studio-1b/Solar-Power-Meter/Mini Digital Current Ammeter Hall Effect.jpg

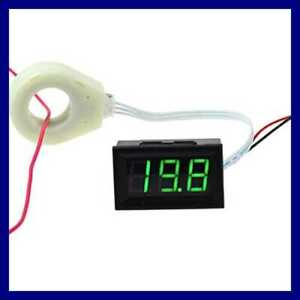
Mini Digital Current Ammeter Hall Effect.jpg
