studio-1b/Solar-Power-Meter/Adafruit 2.13in Monochrome eInk Display 250x122.jpg

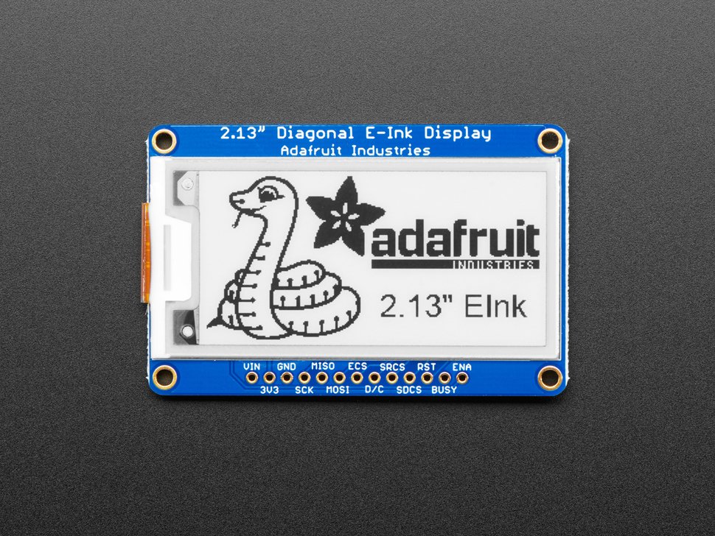
Adafruit 2.13in Monochrome eInk Display 250x122.jpg
