studio-1b/Solar-Power-Meter/README.md

# Solar-Power-Meter
Project to create a power meter for a non-smart solar charger

Blog:https://www.tictawf.com/blog/arduino-centric-solar-power-meter/

Read readme.txt, for a terse UML deployment diagram, for overview of project.  It later has installation instructions.
