studio-1b/Solar-Power-Meter/adafruit 100k potentiometer.jpg

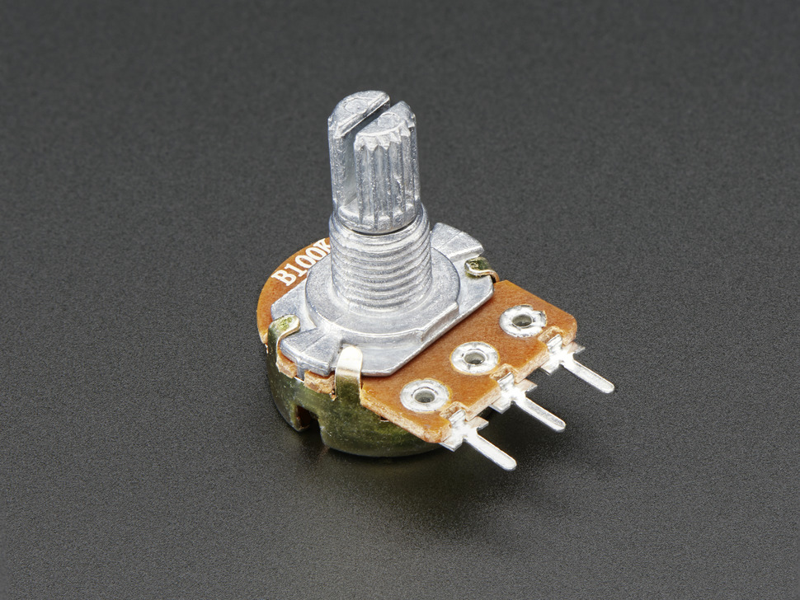
adafruit 100k potentiometer.jpg
