studio-1b/Solar-Power-Meter/arduino diagram.png

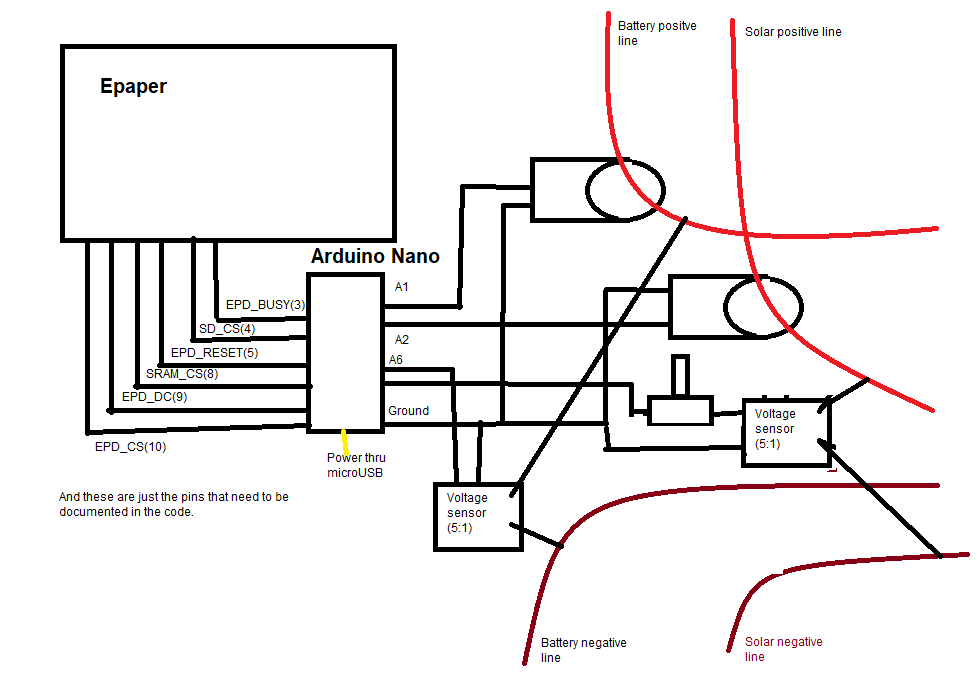
arduino diagram.png
