studio-1b/Solar-Power-Meter/Arduino Nano 33 IoT.jpg

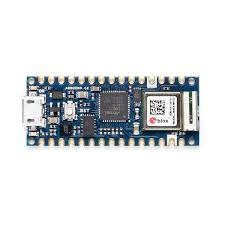
Arduino Nano 33 IoT.jpg
