studio-1b/Solar-Power-Meter/B25 Voltage Sensor Module (5to1 voltage divider).jpg

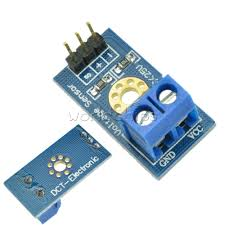
B25 Voltage Sensor Module (5to1 voltage divider).jpg
