studio-1b/Solar-Power-Meter/boardmanager.PNG

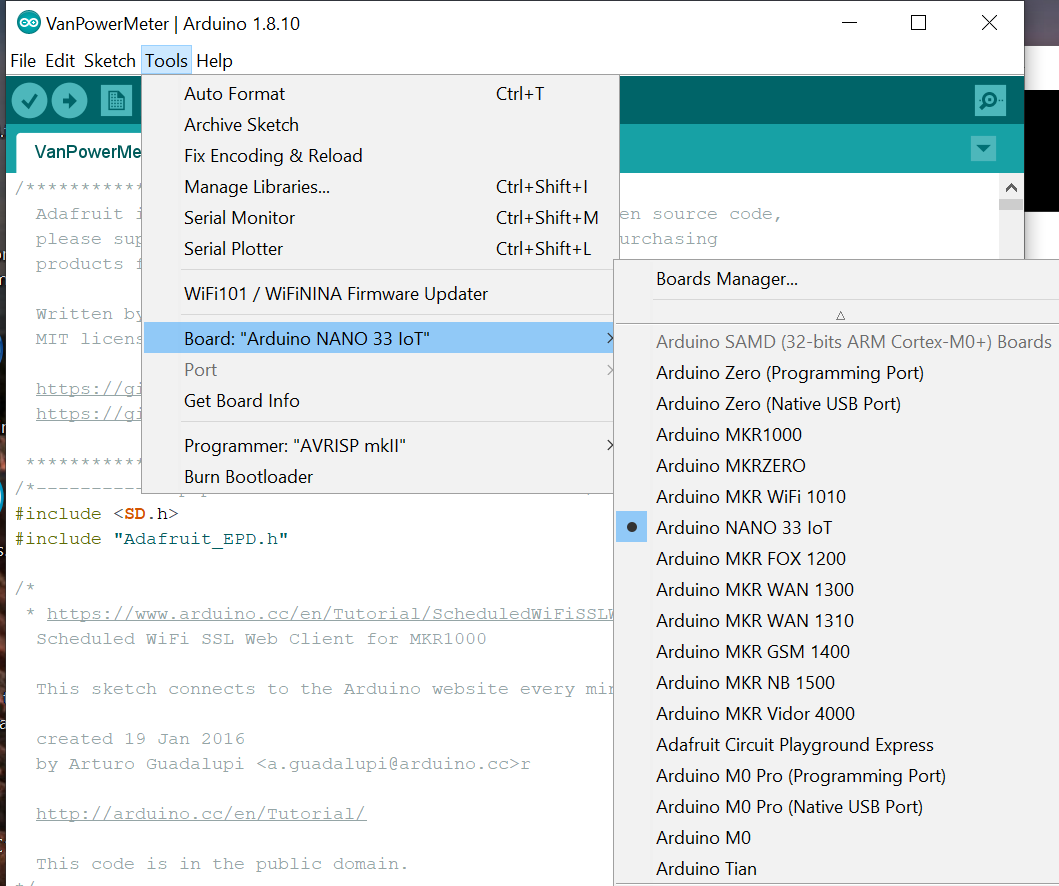
boardmanager.PNG
