studio-1b/Solar-Power-Meter/figurative arduino power sensor.png

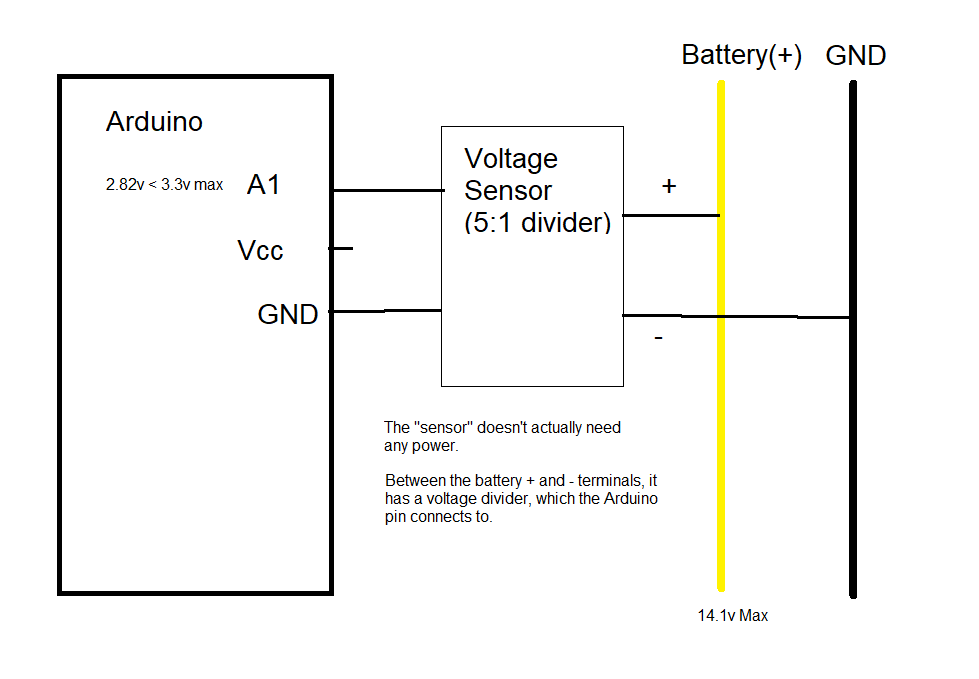
figurative arduino power sensor.png
