studio-1b/Solar-Power-Meter/librarymanager.PNG

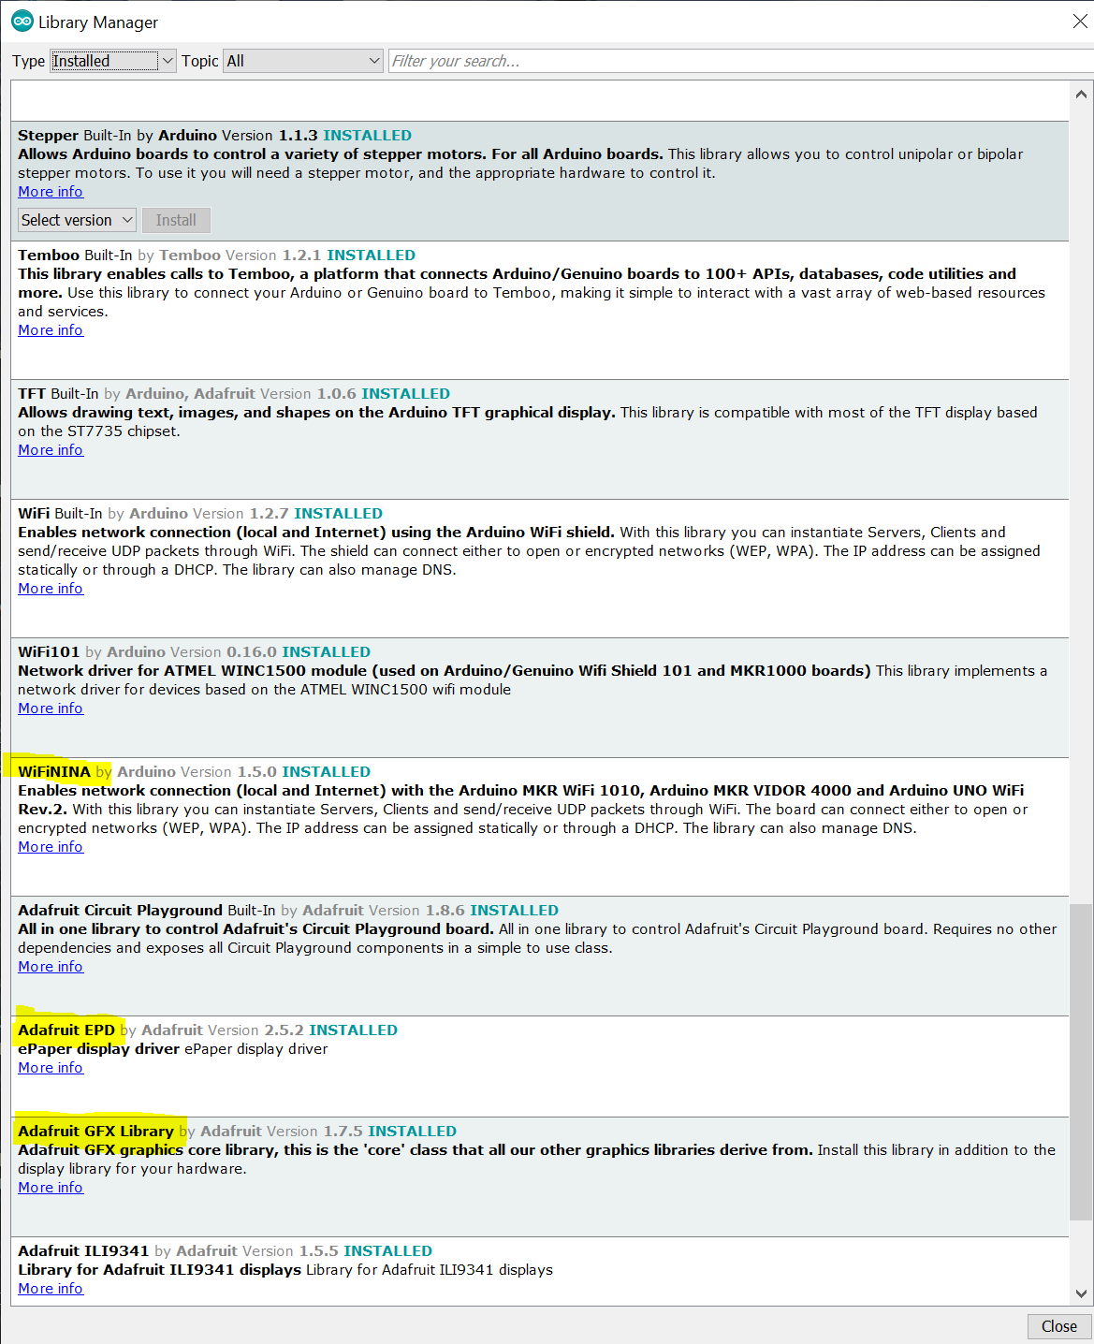
librarymanager.PNG
