studio-1b/Solar-Power-Meter/LinuxCode/HTML/roadtripbusinessend.bmp

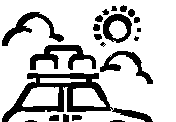
LinuxCode/HTML/roadtripbusinessend.bmp
