studio-1b/Solar-Power-Meter/lubuntu.jpg

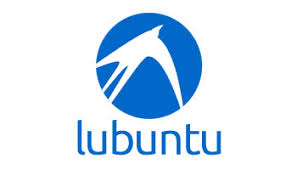
lubuntu.jpg
