studio-1b/Solar-Power-Meter/sample analog sensor.png

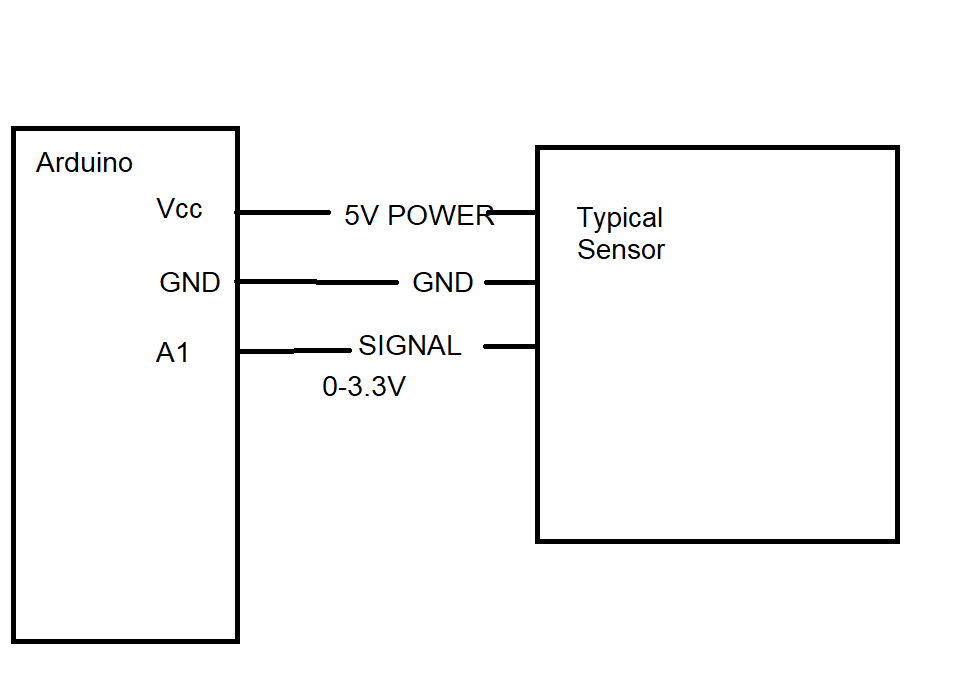
sample analog sensor.png
