studio-1b/Solar-Power-Meter/ArduinoCode/VanPowerMeter.ino

/*
Comments below this comment block, are all credits to people whose code I copied to do this project.


These variables in THIS FILE need to be updated (See right column)

ServerPurpose	Protocol	Type		Variablename
-------------	--------	----		============
heartbeat	http		string		VANPI_WEB_SERVER="ip4 address"
Get time	ntp		IPAddress	gpsServer=IPAddress(0,0,0,0)
						I have private GPSD server,
						but can use public NIST servers
AP association	wifi		IPAddress	THIS_IP=IPAddress(0,0,0,0)
also web server
also sntp

The wifi AP name, and password, need to be updated in arduino_secrets.h

BY: 
1. Yes, all the comments below, are for the .h files
2. Yes, most of the code below is cut-and-paste from example reference code 
   for the specific module supporting the hardware
3. Except the NTP client and server code, which I shamelessly ripped off.
4. And yes, this is my first C program since college.
5. Yes, much of the code is debugging statements, 
   which are controlled by #define DEBUG_??? set to true

For Arduino 33 Nano IOT
Features:
-HTTP Server on port 80 for delivering data, for a datalogger
-NTP client for getting accurate time, for the logger
 -you can configure your own NTP server, if not on internet
-SNTP server, for forwarding time to any other devices
 -drift calculator of emulated clock
-reading analog pins from voltage and current sensors, to be logged
-Epaper UI, to show logged data

The code I copied, I credit with copying their comment headers, before the include libraries they used.
*/



/***************************************************
  Adafruit invests time and resources providing this open source code,
  please support Adafruit and open-source hardware by purchasing
  products from Adafruit!

  Written by Limor Fried/Ladyada for Adafruit Industries.
  MIT license, all text above must be included in any redistribution

  https://github.com/adafruit/Adafruit-GFX-Library
  https://github.com/adafruit/Adafruit_EPD
  
 ****************************************************/
/*----------- epaper includes ---------------------*/
#include <SD.h>
#include "Adafruit_EPD.h"

/*
 * https://www.arduino.cc/en/Tutorial/ScheduledWiFiSSLWebClientfor
  Scheduled WiFi SSL Web Client for MKR1000

  This sketch connects to the Arduino website every minute and downloads the ASCII logo to display it on the serial monitor

  created 19 Jan 2016
  by Arturo Guadalupi <a.guadalupi@arduino.cc>r

  http://arduino.cc/en/Tutorial/

  This code is in the public domain.
*/

#include <SPI.h>
#include <WiFiNINA.h>
#include <RTCZero.h>
#include "arduino_secrets.h" 

/*

 Udp NTP Client

 Get the time from a Network Time Protocol (NTP) time server
 Demonstrates use of UDP sendPacket and ReceivePacket
 For more on NTP time servers and the messages needed to communicate with them,
 see http://en.wikipedia.org/wiki/Network_Time_Protocol

 created 4 Sep 2010
 by Michael Margolis
 modified 9 Apr 2012
 by Tom Igoe

 This code is in the public domain.

 */
#include <WiFiUdp.h>



/* LM: The following is based on NTP_Server_01.ino, downloaded from:
 *     https://forum.arduino.cc/index.php?topic=197870.0
 *     
 *     Original source is named NTP_Server_01.
 *     This sketch includes modifications as summarized below.
 *     
 *                LM:   Platform Arduion Uno + u-blox NEO-M8N
 *     Modifications:   GPS com via _software_ serial (D5 and D6)
 *                      Substitute GPS date/time crack() for library method
 *                      Fix leap year bug for year > 1970
 *                      Invert order of NTP and GPS polling
 *                      Minor trivial changes
 */

/*
  NTP Time Server:
 
 This code is in the public domain.
 */


/*
  Battery Monitor

  This example creates a BLE peripheral with the standard battery service and
  level characteristic. The A0 pin is used to calculate the battery level.

  The circuit:
  - Arduino MKR WiFi 1010, Arduino Uno WiFi Rev2 board, Arduino Nano 33 IoT,
    Arduino Nano 33 BLE, or Arduino Nano 33 BLE Sense board.

  You can use a generic BLE central app, like LightBlue (iOS and Android) or
  nRF Connect (Android), to interact with the services and characteristics
  created in this sketch.

  This example code is in the public domain.
*/

#include <ArduinoBLE.h>


/*
BY: end of includes, and credits
*/





// wifinina lib updated 3/14
#define VERSION               String("0.10.21")
#define SAFE_EPD              false

#define DEBUG_SETUP           false
#define DEBUG_LOOP            false
#define DEBUG_FUNCTIONS       false
#define DEBUG_WIFI            false
#define DEBUG_NTP             false
#define DEBUG_NTPS            false
#define DEBUG_RTC             false
#define DEBUG_HTTP_OUTGOING   false
#define DEBUG_HTTP_INCOMING   false
#define DEBUG_SAMPLING        false
#define DEBUG_BATT_AMP_SAMPL  false
#define DEBUG_BATT_VOLT_SAMPL false
#define DEBUG_SOL_AMP_SAMPL   false
#define DEBUG_SOL_VOLT_SAMPL  false
#define DEBUG_UI              false
#define DEBUG_BMP             false
#define DEBUG_BLE             false
#define DEBUG_FREE_MEMORY     false

#define DEBUG_18V             false
bool isledon = false;

/*----------- epaper defines and global varaiables ---------------------*/
#ifdef ESP8266
   #define SD_CS    2
   #define SRAM_CS 16
   #define EPD_CS   0
   #define EPD_DC   15
#endif
#ifdef ESP32
  #define SD_CS       14
  #define SRAM_CS     32
  #define EPD_CS      15
  #define EPD_DC      33  
#endif
#if defined (__AVR_ATmega32U4__) || defined(ARDUINO_SAMD_FEATHER_M0) || defined(ARDUINO_FEATHER_M4) || defined (__AVR_ATmega328P__) || defined(ARDUINO_NRF52840_FEATHER)
  #define SD_CS       5
  #define SRAM_CS     6
  #define EPD_CS      9
  #define EPD_DC      10  
#endif
#ifdef TEENSYDUINO
  #define SD_CS       8
  #define SRAM_CS     3
  #define EPD_CS      4
  #define EPD_DC      10  
#endif
#ifdef ARDUINO_STM32_FEATHER
   #define TFT_DC   PB4
   #define TFT_CS   PA15
   #define STMPE_CS PC7
   #define SD_CS    PC5
#endif
#ifdef ARDUINO_NRF52832_FEATHER
  #define SD_CS       27
  #define SRAM_CS     30
  #define EPD_CS      31
  #define EPD_DC      11  
#endif
#ifdef ARDUINO_SAMD_NANO_33_IOT  //https://forum.arduino.cc/index.php?topic=636237.0 OR C:\Users\Bob\AppData\Local\Arduino15\packages\arduino\hardware\samd\1.8.4\boards.txt
  #define EPD_DC      9  // https://learn.adafruit.com/adafruit-eink-display-breakouts/arduino-code
  #define EPD_RESET   5  // Normally not defined, and set below
  #define EPD_CS      10 // https://learn.adafruit.com/adafruit-eink-display-breakouts/arduino-code
  #define SRAM_CS     8  // https://learn.adafruit.com/adafruit-eink-display-breakouts/arduino-code
  #define EPD_BUSY    3  // Normally not defined, and set below

  #define SD_CS       4  // Personal Choice to connect to epaper.
#endif

//#define EPD_RESET   -1 // can set to -1 and share with microcontroller Reset!
//#define EPD_BUSY    -1 // can set to -1 to not use a pin (will wait a fixed delay)

/* Uncomment the following line if you are using 2.13" tricolor EPD */
//Adafruit_IL0373 epd(212, 104 ,EPD_DC, EPD_RESET, EPD_CS, SRAM_CS, EPD_BUSY);
/* Uncomment the following line if you are using 2.13" monochrome 250*122 EPD */
Adafruit_SSD1675 epd(250, 122, EPD_DC, EPD_RESET, EPD_CS, SRAM_CS, EPD_BUSY);

//bool drawBitmap = false;
long lastEPDupdatemillis = 0;
bool disableClear = false;



/*----------- Wifi defines and global variables---------------------*/
const String dotToStr = ".";
const String trueToStr = "true";
const String falseToStr = "false";
const String spToStr = " ";

const char null_client_detected_skipping_checking_for_response[] = "null client detected, skipping checking for response";
const char checking_for_http_response[] = "checking for http response";
const char http_response_loop_exit[] = "http response loop exit";
const char received_[] = "received=";
const char __Web[] = "--Web";
const char End_of_HTTP_request_response_parsing_Free_memory_[] = "End of HTTP request/response parsing Free memory=";
const char checking_for_https_response[] = "checking for https response";
const char https_response_loop_exit[] = "https response loop exit";
const char End_of_HTTPS_request_response_parsing_Free_memory_[] = "End of HTTPS request/response parsing, Free memory=";

//char ssid[] = "House";      //  your network SSID (name)
//char pass[] = "@11thAvenue";       // your network password
int keyIndex = 0;                  // your network key Index number (needed only for WEP)

int status = WL_IDLE_STATUS;

// Initialize the Wifi Web client library
//WiFiSSLClient client;
// server address:

//reset
void(*resetFunc)(void) = 0;

// defined web pages to make http requests to
typedef bool (*httpsResponseReceiver)(WiFiSSLClient client);
typedef bool (*httpResponseReceiver)(WiFiClient client);
long uptimeAtAP = 0;

char ARDUINO_WEB_SERVER[] = "www.arduino.cc";
unsigned int ARDUINO_WEB_PORT = 80;
char ARDUINO_LOGO_WEBLOCATION[] = "/asciilogo.txt";

//https://raw.githubusercontent.com/adafruit/Adafruit_Learning_System_Guides/master/EInk_Autostereograms/images/adafruit.bmp
char ADAFRUIT_WEB_SERVER[] = "raw.githubusercontent.com";
unsigned int ADAFRUIT_WEB_PORT = 443;
char ADAFRUIT_LOGO_WEBLOCATION[] = "/adafruit/Adafruit_Learning_System_Guides/master/EInk_Autostereograms/images/adafruit.bmp";

char VANPI_WEB_SERVER[] = GPSD_IP_STR;
unsigned int VANPI_WEB_PORT = 80;
char VANPI_LOGO_WEBLOCATION[] = "/roadtripbusinessend.bmp";

//bool sendRequest = true; // used to understand if the http request must be sent
bool isInternetConnected = false;
bool isNetworkConfigured = false;

/*----------Web Server-----------*/
WiFiServer webserver(80);
//#define REQUESTIN_BUFFER_SIZE 8192
//char httprequestin[REQUESTIN_BUFFER_SIZE]; 


const char HTTP1_1_200_OK[] = "HTTP/1.1 200 OK";
const char Content_Type_text_html[] = "Content-Type: text/html";
const char Connection_close[]="Connection: close";
const char HTML_DOCTYPE_HTML[]="<!DOCTYPE HTML>";
const char HTML_html[]="<html>";
const char HTML_br[]="<br/>";
const char EOL[]="<br />";
const char analog_input[]="analog input ";
const char _is_[]=" is ";
const char  Timestamp_Category_Value_Units_tag_eor[]="Timestamp,Category,Value,Units,tag,<br/>";
const char _SystemVoltage_[]=",SystemVoltage,";
const char milli_[]=",milli-";
const char _BatteryRate_[]=",BatteryRate,";
const char _BatteryNetCharge_[]=",BatteryNetCharge,";
const char _SolarStatus_[]=",SolarStatus,";
const char _SolarSupply_[]=",SolarSupply,";
const char _EstFullCapacity_[]=",EstFullCapacity,";
const char _EstAvailCapacity_[]=",EstAvailCapacity,";
const char _mAh[]=",mAh";
const char EOR[]=",<br />";
const char Timestamp_BatteryAmp_SystemVoltage_SolarStatus_SolarSupply_eor[]="Timestamp,BatteryAmp,SystemVoltage,SolarStatus,SolarSupply,<br />";
const char hourUTC_hourlocal_batterynet_eor[]="hour(UTC),hour(local),batterynet,<br />";
const char TEXT_COMMA[]=",";
const char First_NTP_sync_epoch_[]="First NTP sync epoch = ";
const char Local_time_of_last_outgoing_NTP_sync_request_[]="Local time of last outgoing NTP sync request=";
const char Unix_Epoch_calculated_from_incoming_response_from_NTP_[]="Unix Epoch calculated from incoming response from NTP=";
const char Last_outgoing_NTP_sync_response_sent_to_IP_[] = "Last outgoing NTP sync response sent to IP=";
const char TEXT_PERIOD[]=".";
const char Last_outgoing_NTP_sync_response_sent_epoch_value_[]="Last outgoing NTP sync response sent epoch value=";
const char Number_of_NTP_requests_served_[]="Number of NTP requests served=";
const char Adjustments_to_RTC_actual_elapsed_[]="Adjustments to RTC (actual elapsed)=";
const char _rtc_elapsed___[] = "+(rtc elapsed)*(";
const char TEXT_SLASH[]="/";
const char __eor[]="),<br />";
const char Current_drift_adjustment_to_outgoing_NTP_response[]="Current drift adjustment to outgoing NTP response=";
const char rtc_returned_seconds_elapsed_actual_seconds_elapsed_from_NTP_br[] = "#,rtc returned seconds elapsed, actual seconds elapsed from NTP,<br />";
const char NTP_Sync_Request_received_br[]="NTP Sync Request received<br>";
const char Current_time_is_[] = "Current time is ";
const char NTP_Sync_Request_DENIED_bc_sync_was_just_run_[] = "NTP Sync Request DENIED b/c sync was just run ";
const char seconds_ago_br[] = "seconds ago<br>";
const char br_free_memory_[] = "<br>free memory=";
const char br_raw_[] = "<br>raw=";
const char br_methodcode_[] = "<br>methodcode=";
const char br_line1_[]= "<br>line1=";
const char br_uri_[]= "<br>uri=";
const char br_url_[]= "<br>url=";
const char br_query_[] = "<br>query=";
const char This_url_does_not_exist__No_404_error__But_you_need_to_select_one_of_these_adc_live_powermeter_powerhistory_hourly_ntp[] = "This url does not exist.  No 404 error.  But you need to select one of these: /adc,/live, /powermeter,/powerhistory,/hourly,/ntp";
const char HTML_CHTML[] = "</html>";

const String URL_adc = "/adc";
const String URL_live = "/live";
const String URL_powermeter = "/powermeter";
const String URL_powerhistory = "/powerhistory";
const String URL_hourly = "/hourly";
const String URL_ntp = "/ntp";
const String URL_timesync = "/timesync";



/*----------NTP Client-----------*/
const char Sending_NTP_packet[] = "Sending NTP packet";
const char packet_received[] = "packet received";
const char Seconds_since_Jan_1_1900_[] = "Seconds since Jan 1 1900 = ";
const char Unix_time_[] = "Unix time = ";
const char Epoch_or_date_in_seconds_when_last_synced_with_NTP_[] = "Epoch (or date in seconds) when last synced with NTP = ";
const char Epoch_or_date_in_seconds_of_RTC_[] = "Epoch (or date in seconds) of RTC = ";
const char Seconds_passed_on_RTC_therefore_Expected_from_NTP_[] = "Seconds passed on RTC (therefore Expected from NTP) = ";
const char Epoch_or_date_in_seconds_of_NTP_response_[]  = "Epoch (or date in seconds) of NTP response = ";
const char Seconds_passed_according_to_NTP_therefore_actual_[] = "Seconds passed according to NTP (therefore actual) = ";
const char Data_bin_for_drift_calculation_[] = "Data bin for drift calculation = ";
const char The_UTC_time_is[] = "The_UTC_time_is";
const char __NTP[] = "--NTP";
const char rtc_clock_drift_calculated[] = "rtc clock drift calculated";
const char rtcclock_returned_year_month_day_hr_min_sec_[] = "rtcclock() returned year,month,day,hr,min,sec:";
const char RTC_adjusted_for_drift_to_NTP_server_[] = "RTC adjusted for drift to NTP server: ";
const char sec[] = "sec";
const char End_of_NTPRequest_Free_memory_[] = "End of NTPRequest(), Free memory =";
const char No_NTP_response_received[] = "No NTP response received";

/* Create an rtc object, to handle */
RTCZero rtc;
//const int GMT = 2; //change this to adapt it to your time zone

/*internal storage of timestamps*/
struct utcdatetime {
    unsigned long epoch;
    unsigned int year;
    uint8_t month;
    uint8_t day;
    uint8_t hour;
    uint8_t minute;
    uint8_t second;
};

// NTP sync detail variables
struct utcdatetime datetimeAtConnect;
struct utcdatetime datetimeAtNTP;
unsigned long uptimeAtNTP = 0; 
#define UDP_RESPONSE_PORT 2390        // local port to listen for UDP response
//unsigned int localPort = 2390;      // local port to listen for UDP response
IPAddress timeServer(129, 6, 15, 28); // time.nist.gov NTP server
IPAddress nistServer(129, 6, 15, 28); // time.nist.gov NTP server
IPAddress gpsServer(GPSD_IP_1, GPSD_IP_2, GPSD_IP_3, GPSD_IP_4); // GPSD NTP server
//IPAddress timeServer(128,138,141,172); // utcnist2.colorado.edu NTP server

// A UDP instance to let us send and receive packets over UDP
WiFiUDP Udp2390;
// Global buffer for UDP response packets, and protocol adapter
const int NTP_PACKET_SIZE = 48; // NTP time stamp is in the first 48 bytes of the message
byte packetBuffer[ NTP_PACKET_SIZE]; //buffer to hold incoming and outgoing packets

//Time zone of local
//unsigned long tz = -5; //New York/EST
long tz = -8; //Los Angeles/PST
long tz2 = 0;
String tzabbr = "PST(-8)";

byte rtcdriftindex = 0;
long rtcdriftactual[48];
long rtcdriftexpected[48];
long excludeEpochFromDrift = 0;


/*----------Sensor readings-----------*/
struct linearconv {
    long Bn;
    long Bd;
    long A;
    String units;
};
struct analogsamplesum {
    unsigned long ms;
    unsigned int pin;
    unsigned long count;
    unsigned long sum;
    unsigned int mx;
    unsigned int mn;
    unsigned int avg;
    int calibrate;
    unsigned int tovolts;
    struct linearconv* converter;
    int converted;
};
int fudge_for_ammeter = 1676-1686; //1700, 1676-1710; //-30 //bottom one
int fudge_for_ammeter2 = 1676-1672; //1676-1686 //top one
int fudge_for_voltameter = 2474-2502; //2545; //-69
int sample_count = 300; // 300 is biggest sample for 12bit dac before overflow long numerator of average : 300*4095*3300=4,054,050,000
int sample_delay = 0;
struct linearconv ANALOG_VOLT_TO_AMP = {100,1,-167600, "amps"};  //every millivolt is an amp
//1676*1000 = 1676000
struct linearconv ANALOG_VOLT_TO_12V = {5,1,0, "volts"};  //every millivolt is an amp
//10.81 multimeter on battery
//2.162 multimeter on divider lead
//1.823 on potentiometer lead
//  for 0.84181313 ratio between the 2 voltage divider (1st is 5:1 ratio)
// 1/5 * 1.823/2.162 = 1.823/(5*2.162) = 1.823/10.81 = 1/5.929786 is ratio on second divider
struct linearconv ANALOG_VOLT_TO_18V = {593,100,0, "volts"};  //200Kohm resister on divider made ratio 


// sampling interval control variables
struct aggregate {
    long count;
    long sum;
    int mx;
    int mn;
    int avg;
    struct linearconv* converter;
    int converted;
};
unsigned long nowAhMillis;
long totalAh;
long nowAh;
long nowAhCount;
long nowAhInterval = 60000;
long dischargedAh=0; // should be negative or 0.  Never positive
bool isdischargeestimate = true;
long batteryCapacityAh = 300000;
long lostCapacityAh    = 0;
long sampleStartMillis=0;
unsigned long samplesetMillis;
struct utcdatetime totalAhDatetime;
typedef unsigned long (*MillisGenerator)();
typedef unsigned int (*HourGenerator) ();
MillisGenerator currentMillis;
HourGenerator prevHour;
HourGenerator nowHour;


struct aggregate hourlyAmpSum[24];

struct analogsamplesum amperesMinuteTot = {0, A1, 1, 2048, 0 ,0, 2048, fudge_for_ammeter2, 1676, &ANALOG_VOLT_TO_AMP, 0};
struct analogsamplesum voltageMinuteTot = {0, A6, 0, 0, 0 ,0, 0, fudge_for_voltameter, 0, &ANALOG_VOLT_TO_12V, 0};
struct analogsamplesum solarMinuteTotA = {0, A2, 1, 2048, 0 ,0, 2048, fudge_for_ammeter,1676, &ANALOG_VOLT_TO_AMP, 0};
struct analogsamplesum solarMinuteTotV = {0, A7, 0, 0, 0 ,0, 0, fudge_for_voltameter, 0, &ANALOG_VOLT_TO_18V, 0};

struct analogsamplesum amperesForWeb;
struct analogsamplesum voltageForWeb;
struct analogsamplesum solarAmpForWeb;
struct analogsamplesum solarVoltForWeb;


/* high level drawing routines */
//drawgraph() enumerations
#define NO_BORDER 0
#define SHOW_XY_AXIS 1
#define SHOW_XY_AXIS_W_BORDERS 2
#define DATA_COUNT 144

//data to send to drawgraph() to recreate graph
byte graphdatahead = 0;
//struct utcdatetime datatime[DATA_COUNT]; 
int batteryamppxgraph[DATA_COUNT]; 
int batteryvoltpxgraph[DATA_COUNT]; 
int solaramppxgraph[DATA_COUNT];
int solarvoltpxgraph[DATA_COUNT]; 
//int graphactualmah[DATA_COUNT];

struct downloadable_history {
    //unsigned long epoch;
    struct utcdatetime utc;
    
    int batterymA; //milliamps
    int batterymV; //millivolts
    int solarmA; //milliamps
    int solarmV; //millivolts
}; // it's stored in millivolts and milliamps, but the resolution of the analog readings isn't that good.  Maybe to the tenths place.  The extra numbers are just to support arithmetic and rounding support.
// 12-bit adc means 4096 values, which to have milli-resolution, the thing being measured can only have range 0 to 4.1
struct downloadable_history readings[DATA_COUNT];

// just counters for debugging what is a zero level for amp sensor
long debugginglongtermA = 0;
long debugginglongtermCount = 0;
long debugginglongSolarA = 0;


#define MIN_PER_GRAPH_PX  10 // 144 graph data points.  So 1 means >2hours on graph.  10 means 1440min or 24hours.

typedef void (*DataPoint) (const unsigned int zeroX, const unsigned int zeroY, const int rangePY, const int rangeNY, const int x0, const int y0, const int x1, const int y1);
typedef void (*AxesTick) (const int l, const int t, const int color);

typedef int (*ToPx) (const int y);
struct graphproperties {
    unsigned int zeroX;
    unsigned int zeroY;
    
    int rangePlusY;
    int rangeNegY;
    int rangePlusX;
    int rangeNegX;

    unsigned int lastDataX;
    unsigned int lastDataY;
};

//       overflow for long/ nominal voltage reading = number of readings before overflow
//decide 4000000000/(12000) = 333333.333
//333333.333/60 = 5555.555, assuming 1min per reading, 5555 hours before overflow
//5555.55 / 24 = 231 days before overflow
//so let's log every minute's Ah for an hour, then add that value to a uptime aggregate Ah value.  
//...There is no way that this overflows for a van.  The battery should run out of power.

// 12.75 to 11.50, 
//unsigned byte soc[120] = {};
//trying to set an initial maxAh, from boot

//what to graph, if NTP is unavailable?

// for NTP vs RTC drift calculator
struct linearconv rtcdrift = {0,21600,0,"sec"}; //6 hours = 21600, so the least sqr regression should return in fraction of 21600


/*----------NTP server-----------*/
// All code copied from http://lloydm.net/Demos/NTP/NTP-GPS_Server.ino.txt
//
// buffers for receiving and sending data
const int NTPS_PACKET_SIZE = 48; //same as above sending, and receiving response, but separate instance
byte packetBuffer2[NTPS_PACKET_SIZE];  // same as sending, and receiving response

const char Checking_if_NTP_request_received_on_port_123___[] = "Checking if NTP request received on port 123...";
const char Received_UDP_packet_size_[] = "Received UDP packet size ";
const char From_[] = "From ";
const char __port_[] = ", port ";
const char LI_Vers_Mode_[] = "  LI, Vers, Mode :";
const char Stratum_[] = "  Stratum :";
const char Polling_[] = "  Polling :";
const char Precision_[] = "  Precision :";
const char packet_dump_[] = "packet dump:";
const char Local_time_is_[] = "Local time is =";
const char UTC_Time_in_seconds_[] ="UTC Time in seconds="; 
const char Drift_of_clock_calculated_is_[] = "Drift of clock calculated is="; 
const char UTC_Time_sent_[] = "UTC Time sent="; 
const char Time_sent_is_supposed_to_be_[] = "Time sent is supposed to be =";
const char No_NTP_request_received[] = "No NTP request received";

byte lastremoteip[4];
unsigned long lastremoteepoch;
unsigned long ntpscount;


/*----------Bluetooth-----------*/


BLEService btService("19B10000-E8F2-537E-4F6C-D104768A1214"); // BLE LED Service

// BLE LED Switch Characteristic - custom 128-bit UUID, read and writable by central
BLEUnsignedIntCharacteristic systemVoltageCharacteristic("19B10001-E8F2-537E-4F6C-D104768A1214", BLERead);
BLEUnsignedIntCharacteristic solarVoltageCharacteristic("19B10001-E8F2-537E-4F6C-D104768A1215", BLERead);
BLEIntCharacteristic batterymAmpsCharacteristic("19B10001-E8F2-537E-4F6C-D104768A1216", BLERead);
BLEIntCharacteristic solarmAmpsCharacteristic("19B10001-E8F2-537E-4F6C-D104768A1217", BLERead);
BLELongCharacteristic batteryNetmAhCharacteristic("19B10001-E8F2-537E-4F6C-D104768A1218", BLERead);
BLELongCharacteristic batteryTopDischargemAhCharacteristic("19B10001-E8F2-537E-4F6C-D104768A1219", BLERead);

//BLEUnsignedCharCharacteristic









/*---------------------------------------------------
----------------------------------------------------

Run once at boot

-----------------------------------------------------
----------------------------------------------------*/

void setup() {
  //setDebugMessageLevel(3); // used to set a level of granularity in information output [0...4]
  // initialize digital pin LED_BUILTIN as an output.
  pinMode(LED_BUILTIN, OUTPUT);
  
  /*----------- epaper ---------------------*/
  Serial.begin(115200);

  if(DEBUG_SETUP) {
    for(int i=0; i<2000; i++)
      Serial.print(".");
    Serial.println();
    Serial.println();
    
    Serial.println(F("Van Power Meter Starting"));
    Serial.println(F("setup() enter"));
    
    Serial.print(F("Initializing SD card..."));
  }
  bool drawBitmap =false;
  if (!SD.begin(SD_CS)) {
    if(DEBUG_SETUP) Serial.println(F("failed!"));
  } else {
    drawBitmap = true;
    File root = SD.open("/");
    printDirectory(root, 0);
    if(DEBUG_SETUP) Serial.println(F("done!"));
  }

  if(DEBUG_SETUP) {
    Serial.println(F("Big object sizes..."));


    long bigobjects = 0;
//    Serial.println(F("Graph Data x-axis dates:"));
//    Serial.print(sizeof(datatime));
//    bigobjects += sizeof(datatime);
//    Serial.print(F(" / "));
//    Serial.println(bigobjects);
    
    Serial.println(F("Graph Data y-axis voltage values:"));
    Serial.print(sizeof(batteryvoltpxgraph));
    bigobjects += sizeof(batteryvoltpxgraph);
    Serial.print(F(" / "));
    Serial.println(bigobjects);

    Serial.println(F("Graph Data y-axis amp values:"));
    Serial.print(sizeof(solaramppxgraph));
    bigobjects += sizeof(solaramppxgraph);
    Serial.print(F(" / "));
    Serial.println(bigobjects);

    Serial.println(F("Graph Data y-axis solar voltage values:"));
    Serial.print(sizeof(solarvoltpxgraph));
    bigobjects += sizeof(solarvoltpxgraph);
    Serial.print(F(" / "));
    Serial.println(bigobjects);

    //Serial.println(F("Graph Data integration of y-values :"));
    //Serial.print(sizeof(graphactualmah));
    //bigobjects += sizeof(graphactualmah);
    //Serial.print(F(" / "));
    //Serial.println(bigobjects);


    Serial.println(F("Daily amp (dis)charge avg by hour :"));
    Serial.print(sizeof(hourlyAmpSum));
    bigobjects += sizeof(hourlyAmpSum);
    Serial.print(F(" / "));
    Serial.println(bigobjects);

    
//    Serial.println("History Timestamps :");
//    Serial.print(sizeof(historytimestamp));
//    bigobjects += sizeof(utcdatetime) * HISTORY_LENGTH;
//    Serial.print(" / ");
//    Serial.println(bigobjects);

    Serial.println(F("History Readings :"));
//    Serial.print(sizeof(historyamp) + sizeof(historyvolt) + sizeof(historysolarvolt) + sizeof(historysolaramp) );
//    bigobjects += sizeof(historyamp) + sizeof(historyvolt) + sizeof(historysolarvolt) + sizeof(historysolaramp);
    Serial.print(sizeof(readings));
    bigobjects += sizeof(readings);
    Serial.print(F(" / "));
    Serial.println(bigobjects);
    
    Serial.println(F("Total array initialization:"));
    Serial.print(bigobjects);
    Serial.println(F("/32,000 SRAM for Arduino Nano 33 IoT"));
    //https://www.mouser.com/new/arduino/arduino-nano-33-iot/

    
    Serial.println(F("Strings in constant area :"));

    Serial.print(dotToStr);
    Serial.print(sizeof(dotToStr) + dotToStr.length());
    bigobjects += sizeof(dotToStr + dotToStr.length());
    Serial.print(F(" / "));
    Serial.println(bigobjects);
    
    Serial.print(trueToStr);
    Serial.print(sizeof(trueToStr) + trueToStr.length());
    bigobjects += sizeof(trueToStr + trueToStr.length());
    Serial.print(F(" / "));
    Serial.println(bigobjects);
    
    Serial.print(falseToStr);
    Serial.print(sizeof(falseToStr) + falseToStr.length());
    bigobjects += sizeof(falseToStr + falseToStr.length());
    Serial.print(F(" / "));
    Serial.println(bigobjects);
    
    Serial.print(spToStr);
    Serial.print(sizeof(spToStr) + spToStr.length());
    bigobjects += sizeof(spToStr + spToStr.length());
    Serial.print(F(" / "));
    Serial.println(bigobjects);

    
    Serial.print(Checking_if_NTP_request_received_on_port_123___);
    Serial.print(sizeof(Checking_if_NTP_request_received_on_port_123___));
    bigobjects += sizeof(Checking_if_NTP_request_received_on_port_123___);
    Serial.print(F(" / "));
    Serial.println(bigobjects);

    Serial.print(Received_UDP_packet_size_);
    Serial.print(sizeof(Received_UDP_packet_size_) );
    bigobjects += sizeof(Received_UDP_packet_size_);
    Serial.print(F(" / "));
    Serial.println(bigobjects);

    Serial.print(From_);
    Serial.print(sizeof(From_));
    bigobjects += sizeof(From_);
    Serial.print(F(" / "));
    Serial.println(bigobjects);

    Serial.print(__port_);
    Serial.print(sizeof(__port_));
    bigobjects += sizeof(__port_);
    Serial.print(F(" / "));
    Serial.println(bigobjects);

    Serial.print(LI_Vers_Mode_);
    Serial.print(sizeof(LI_Vers_Mode_));
    bigobjects += sizeof(LI_Vers_Mode_);
    Serial.print(F(" / "));
    Serial.println(bigobjects);

    Serial.print(Stratum_);
    Serial.print(sizeof(Stratum_));
    bigobjects += sizeof(Stratum_);
    Serial.print(F(" / "));
    Serial.println(bigobjects);
    
    Serial.print(Polling_);
    Serial.print(sizeof(Polling_));
    bigobjects += sizeof(Polling_);
    Serial.print(F(" / "));
    Serial.println(bigobjects);
    
    Serial.print(Precision_);
    Serial.print(sizeof(Precision_));
    bigobjects += sizeof(Precision_);
    Serial.print(F(" / "));
    Serial.println(bigobjects);

    Serial.print(packet_dump_);
    Serial.print(sizeof(packet_dump_));
    bigobjects += sizeof(packet_dump_);
    Serial.print(F(" / "));
    Serial.println(bigobjects);

    Serial.print(Local_time_is_);
    Serial.print(sizeof(Local_time_is_));
    bigobjects += sizeof(Local_time_is_);
    Serial.print(F(" / "));
    Serial.println(bigobjects);

    Serial.print(UTC_Time_in_seconds_);
    Serial.print(sizeof(UTC_Time_in_seconds_));
    bigobjects += sizeof(UTC_Time_in_seconds_);
    Serial.print(F(" / "));
    Serial.println(bigobjects);

    Serial.print(Drift_of_clock_calculated_is_);
    Serial.print(sizeof(Drift_of_clock_calculated_is_));
    bigobjects += sizeof(Drift_of_clock_calculated_is_);
    Serial.print(F(" / "));
    Serial.println(bigobjects);

    Serial.print(UTC_Time_sent_);
    Serial.print(sizeof(UTC_Time_sent_));
    bigobjects += sizeof(UTC_Time_sent_);
    Serial.print(F(" / "));
    Serial.println(bigobjects);

    Serial.print(Time_sent_is_supposed_to_be_);
    Serial.print(sizeof(Time_sent_is_supposed_to_be_));
    bigobjects += sizeof(Time_sent_is_supposed_to_be_);
    Serial.print(F(" / "));
    Serial.println(bigobjects);

    Serial.print(No_NTP_request_received);
    Serial.print(sizeof(No_NTP_request_received));
    bigobjects += sizeof(No_NTP_request_received);
    Serial.print(F(" / "));
    Serial.println(bigobjects);

    Serial.print(null_client_detected_skipping_checking_for_response);
    Serial.print(sizeof(null_client_detected_skipping_checking_for_response));
    bigobjects += sizeof(null_client_detected_skipping_checking_for_response);
    Serial.print(F(" / "));
    Serial.println(bigobjects);

    Serial.print(checking_for_http_response);
    Serial.print(sizeof(checking_for_http_response));
    bigobjects += sizeof(checking_for_http_response);
    Serial.print(F(" / "));
    Serial.println(bigobjects);

    Serial.print(http_response_loop_exit);
    Serial.print(sizeof(http_response_loop_exit));
    bigobjects += sizeof(http_response_loop_exit);
    Serial.print(F(" / "));
    Serial.println(bigobjects);

    Serial.print(received_);
    Serial.print(sizeof(received_));
    bigobjects += sizeof(received_);
    Serial.print(F(" / "));
    Serial.println(bigobjects);

    Serial.print(__Web);
    Serial.print(sizeof(__Web));
    bigobjects += sizeof(__Web);
    Serial.print(F(" / "));
    Serial.println(bigobjects);

    Serial.print(End_of_HTTP_request_response_parsing_Free_memory_);
    Serial.print(sizeof(End_of_HTTP_request_response_parsing_Free_memory_));
    bigobjects += sizeof(End_of_HTTP_request_response_parsing_Free_memory_);
    Serial.print(F(" / "));
    Serial.println(bigobjects);

    Serial.print(checking_for_https_response);
    Serial.print(sizeof(checking_for_https_response));
    bigobjects += sizeof(checking_for_https_response);
    Serial.print(F(" / "));
    Serial.println(bigobjects);

    Serial.print(https_response_loop_exit);
    Serial.print(sizeof(https_response_loop_exit));
    bigobjects += sizeof(https_response_loop_exit);
    Serial.print(F(" / "));
    Serial.println(bigobjects);

    Serial.print(End_of_HTTPS_request_response_parsing_Free_memory_);
    Serial.print(sizeof(End_of_HTTPS_request_response_parsing_Free_memory_));
    bigobjects += sizeof(End_of_HTTPS_request_response_parsing_Free_memory_);
    Serial.print(F(" / "));
    Serial.println(bigobjects);


    Serial.print(Sending_NTP_packet);
    Serial.print(sizeof(Sending_NTP_packet));
    bigobjects += sizeof(Sending_NTP_packet);
    Serial.print(F(" / "));
    Serial.println(bigobjects);

    Serial.print(packet_received);
    Serial.print(sizeof(packet_received));
    bigobjects += sizeof(packet_received);
    Serial.print(F(" / "));
    Serial.println(bigobjects);

    Serial.print(Seconds_since_Jan_1_1900_);
    Serial.print(sizeof(Seconds_since_Jan_1_1900_));
    bigobjects += sizeof(Seconds_since_Jan_1_1900_);
    Serial.print(F(" / "));
    Serial.println(bigobjects);

    Serial.print(Unix_time_);
    Serial.print(sizeof(Unix_time_));
    bigobjects += sizeof(Unix_time_);
    Serial.print(F(" / "));
    Serial.println(bigobjects);

    Serial.print(Epoch_or_date_in_seconds_when_last_synced_with_NTP_);
    Serial.print(sizeof(Epoch_or_date_in_seconds_when_last_synced_with_NTP_));
    bigobjects += sizeof(Epoch_or_date_in_seconds_when_last_synced_with_NTP_);
    Serial.print(F(" / "));
    Serial.println(bigobjects);

    Serial.print(Epoch_or_date_in_seconds_of_RTC_);
    Serial.print(sizeof(Epoch_or_date_in_seconds_of_RTC_));
    bigobjects += sizeof(Epoch_or_date_in_seconds_of_RTC_);
    Serial.print(F(" / "));
    Serial.println(bigobjects);

    Serial.print(Seconds_passed_on_RTC_therefore_Expected_from_NTP_);
    Serial.print(sizeof(Seconds_passed_on_RTC_therefore_Expected_from_NTP_));
    bigobjects += sizeof(Seconds_passed_on_RTC_therefore_Expected_from_NTP_);
    Serial.print(F(" / "));
    Serial.println(bigobjects);

    Serial.print(Epoch_or_date_in_seconds_of_NTP_response_);
    Serial.print(sizeof(Epoch_or_date_in_seconds_of_NTP_response_));
    bigobjects += sizeof(Epoch_or_date_in_seconds_of_NTP_response_);
    Serial.print(F(" / "));
    Serial.println(bigobjects);
    
    Serial.print(Seconds_passed_according_to_NTP_therefore_actual_);
    Serial.print(sizeof(Seconds_passed_according_to_NTP_therefore_actual_));
    bigobjects += sizeof(Seconds_passed_according_to_NTP_therefore_actual_);
    Serial.print(F(" / "));
    Serial.println(bigobjects);

    Serial.print(Data_bin_for_drift_calculation_);
    Serial.print(sizeof(Data_bin_for_drift_calculation_));
    bigobjects += sizeof(Data_bin_for_drift_calculation_);
    Serial.print(F(" / "));
    Serial.println(bigobjects);

    Serial.print(The_UTC_time_is);
    Serial.print(sizeof(The_UTC_time_is));
    bigobjects += sizeof(The_UTC_time_is);
    Serial.print(F(" / "));
    Serial.println(bigobjects);

    Serial.print(__NTP);
    Serial.print(sizeof(__NTP));
    bigobjects += sizeof(__NTP);
    Serial.print(F(" / "));
    Serial.println(bigobjects);

    Serial.print(rtc_clock_drift_calculated);
    Serial.print(sizeof(rtc_clock_drift_calculated));
    bigobjects += sizeof(rtc_clock_drift_calculated);
    Serial.print(F(" / "));
    Serial.println(bigobjects);

    Serial.print(rtcclock_returned_year_month_day_hr_min_sec_);
    Serial.print(sizeof(rtcclock_returned_year_month_day_hr_min_sec_));
    bigobjects += sizeof(rtcclock_returned_year_month_day_hr_min_sec_);
    Serial.print(F(" / "));
    Serial.println(bigobjects);

    Serial.print(RTC_adjusted_for_drift_to_NTP_server_);
    Serial.print(sizeof(RTC_adjusted_for_drift_to_NTP_server_));
    bigobjects += sizeof(RTC_adjusted_for_drift_to_NTP_server_);
    Serial.print(F(" / "));
    Serial.println(bigobjects);

    Serial.print(sec);
    Serial.print(sizeof(sec));
    bigobjects += sizeof(sec);
    Serial.print(F(" / "));
    Serial.println(bigobjects);

    Serial.print(End_of_NTPRequest_Free_memory_);
    Serial.print(sizeof(End_of_NTPRequest_Free_memory_));
    bigobjects += sizeof(End_of_NTPRequest_Free_memory_);
    Serial.print(F(" / "));
    Serial.println(bigobjects);

    Serial.print(No_NTP_response_received);
    Serial.print(sizeof(No_NTP_response_received));
    bigobjects += sizeof(No_NTP_response_received);
    Serial.print(F(" / "));
    Serial.println(bigobjects);

    
    Serial.print(URL_adc);
    Serial.print(sizeof(URL_adc));
    bigobjects += sizeof(URL_adc);
    Serial.print(F(" / "));
    Serial.println(bigobjects);
    
    Serial.print(URL_live);
    Serial.print(sizeof(URL_live));
    bigobjects += sizeof(URL_live);
    Serial.print(F(" / "));
    Serial.println(bigobjects);
    
    Serial.print(URL_powermeter);
    Serial.print(sizeof(URL_powermeter));
    bigobjects += sizeof(URL_powermeter);
    Serial.print(F(" / "));
    Serial.println(bigobjects);
    
    Serial.print(URL_powerhistory);
    Serial.print(sizeof(URL_powerhistory));
    bigobjects += sizeof(URL_powerhistory);
    Serial.print(F(" / "));
    Serial.println(bigobjects);
    
    Serial.print(URL_hourly);
    Serial.print(sizeof(URL_hourly));
    bigobjects += sizeof(URL_hourly);
    Serial.print(F(" / "));
    Serial.println(bigobjects);
    
    Serial.print(URL_ntp);
    Serial.print(sizeof(URL_ntp));
    bigobjects += sizeof(URL_ntp);
    Serial.print(F(" / "));
    Serial.println(bigobjects);
    
    Serial.print(URL_timesync);
    Serial.print(sizeof(URL_timesync));
    bigobjects += sizeof(URL_timesync);
    Serial.print(F(" / "));
    Serial.println(bigobjects);


    Serial.println(F("Partial string initialization + array:"));
    Serial.print(bigobjects);
    Serial.println(F("/32,000 SRAM for Arduino Nano 33 IoT"));
    //https://www.mouser.com/new/arduino/arduino-nano-33-iot/

  }
  

  if(DEBUG_SETUP) Serial.println(F("EPD begin"));
  epd.begin();
  epd.setTextWrap(true);
  epd.setTextSize(1);

  if(DEBUG_SETUP) Serial.println(F("Starting e-paper startup self-diagnostic... it just draws random stuff so you know it's working"));
  // Draw a bitmap
  if (drawBitmap) {
    epd.clearBuffer();  
    epd.fillScreen(EPD_WHITE);
    bmpDraw("/blinka.bmp",0,0);
  
    delay(15*1000);
  }
  startupdraw();

  //initialize critical method calls, to see if the stack space is sufficient.
  //initializing here, puts any variables that seem persistent on the heap, at the bottom of the heap
  //so that fragmentation can be fixed.
  if(DEBUG_FREE_MEMORY) {
    Serial.print(F("Before intializing critical methods, Free memory="));
    Serial.println(freeMemory());    
  }
  //for listenTo...(), the isNetworkConfigured is currently false, so it will abort checking for HTTP response, regardless of input parameters
  listenToClient(NULL);
  listenToSslClient(NULL);
  if(DEBUG_FREE_MEMORY) {
    Serial.print(F("After intializing critical methods, Free memory="));
    Serial.println(freeMemory());    
  }


  /*----------- Wifi ---------------------*/
  connectToAP();    // connect the board to the access point

  // always start whether or not connection is made, waiting for it to connect later.  
  // restarting these services at reconnect might cause malfunction.  
  // Unfortunately, no way to tell if after wifi connection and disconnection, to check these services are still ok
  if(DEBUG_SETUP) Serial.println(F("starting HTTP server"));
  webserver.begin(); 
  if(DEBUG_SETUP) Serial.println(F("starting response listener for NTP request"));
  Udp2390.begin(UDP_RESPONSE_PORT); // unfortunately to be lazy at code, we listen even when we don't send a request.  Just ignore, and flush it before we send a NTP request
  if(DEBUG_SETUP) Serial.println(F("starting NTPS"));
  startServerNTP();
      
  if(isWifiConnected()) {
    if(DEBUG_SETUP) Serial.println(F("setup() Wifi connected"));
    printWifiStatus();

    /*-- Webserver... It's going to be at least 45seconds before next service --*/
    if(DEBUG_SETUP) Serial.println(F("initial HTTP request check"));
    httprequesthandle();
  
    /*------------NTP UDP--------------------------*/
    if(DEBUG_SETUP) Serial.println(F("sending NTP request for current time"));
    
    // unsigned long epoch = WiFi.getTime(); //used the old examples for NTP b/c I can't figure out where to change the NTP server in this call
    // rtc.setEpoch(epoch); //so this line is in ntprequest(), after custom coded call to NTP
    rtc.begin();
    ntprequest(); // this will assume NIST server, so van boot will take a little longer NIST doesnt respond.
    delay(15000); //force a delay here...

    if(DEBUG_FREE_MEMORY) {
      Serial.print(F("After starting NTPS, Free memory="));
      Serial.println(freeMemory());    
    }
      
    // Check connectivity to Internet thru website
    if(DEBUG_SETUP) Serial.println(F("making http request"));
    configureNetwork();
    //httpRequest(ARDUINO_WEB_SERVER, ARDUINO_LOGO_WEBLOCATION, ARDUINO_WEB_PORT);
    //disableClear = true;
    //httpsRequest(ADAFRUIT_WEB_SERVER, ADAFRUIT_LOGO_WEBLOCATION, ADAFRUIT_WEB_PORT);
    //disableClear = false;
  }

  /*------------ Sensor Data collection setup --------------------------*/
  analogReadResolution(12);

  for(int i=0; i<DATA_COUNT; i++) {
    readings[i].utc.epoch=0;
  }

  //1676*4095/3300 = 2079.7636
  struct aggregate zeroreadingAh = {0 ,0, 0, 0, 0, NULL, 0};
  for(int i=0; i<24; i++)
    hourlyAmpSum[i] = zeroreadingAh;
  
  // there are two counters.  one that resets at top of second hand, another resets at top of hour hand.
  if(validclock()) { // we want samplesets to reset on the minute hand of clock
    currentMillis = rtcMinuteMillis;
    prevHour = rtcPrevHour;
    nowHour = rtcNowHour;

    samplesetMillis = millis();
    struct utcdatetime now = rtcclock();

    samplesetMillis -= now.second*1000;
    nowAhMillis = samplesetMillis; // - now.minute*60000UL;
    totalAhDatetime = now;
    nowAhInterval = samplesetMillis + (60-now.minute)*60000UL;
    
  } else {
    currentMillis = uptimeMinuteMillis;
    prevHour = uptimePrevHour;
    nowHour = uptimeNowHour;

    samplesetMillis = millis(); //we have no clock, so we can't tell which minute is is, anymore.
    nowAhMillis = samplesetMillis;
  }
  

  if(DEBUG_SETUP) Serial.println(F("Initial sensor readings"));
  struct analogsamplesum amperes = amperesForWeb = getsample(A1, fudge_for_ammeter2, &ANALOG_VOLT_TO_AMP);
  struct analogsamplesum voltage = voltageForWeb = getsample(A6, fudge_for_voltameter, &ANALOG_VOLT_TO_12V);
  struct analogsamplesum solarA = solarAmpForWeb = getsample(A2, fudge_for_ammeter, &ANALOG_VOLT_TO_AMP);
  struct analogsamplesum solarV = solarVoltForWeb = getsample(A7, fudge_for_voltameter, &ANALOG_VOLT_TO_18V);
  // absAmpReading(&solarA);
  solarAmpForWeb = solarA;

//struct analogsamplesum amperesForWeb;
//struct analogsamplesum voltageForWeb;
//struct analogsamplesum solarAmpForWeb;
//struct analogsamplesum solarVoltForWeb;

  if(DEBUG_SETUP) {
    struct analogsamplesum tmp = getsample(A2, fudge_for_ammeter, &ANALOG_VOLT_TO_AMP);
    for(int i=0; i<4096; i++) {
      tmp.sum = tmp.count * i;
      computesampleAvg(&tmp);
      computesampleVolts(&tmp);
      computesampleConversion(&tmp);
      Serial.print(F("Test reading="));
      Serial.print(tmp.avg);
      Serial.print(F(" mv="));
      Serial.print(tmp.tovolts);
      Serial.print(F(" amps="));
      Serial.print(tmp.converted);
      absAmpReading(&tmp);
      Serial.print(F("       ABS'ed="));
      Serial.print(tmp.avg);
      Serial.print(F(" mv="));
      Serial.print(tmp.tovolts);
      Serial.print(F(" amp="));
      Serial.println(tmp.converted);
    }
  }
  
  // estimate battery state of change and current capacity supported
  // first establish depth of discharge. maxAh = -50ah
  // then use amp hours from then on, another -50ah = -100ah, or 33%
  // then use amp house from then on, another + 70ah = -30ah, etc
  // but when amps <1 and voltage > 13, this means it's fullly charged
  // if ah =-30, interpret real capacity has decreased and this is new capacity    
  if(DEBUG_SETUP) {
    Serial.println(F("Initializing depth of discharge"));
    Serial.println(F("discharge table"));
    Serial.print("     ");
    for(int amp=0; amp<20000; amp+=2000) {
      Serial.print(amp);
      Serial.print(F("mA|"));
    }
    Serial.println();
    for(int volt=12700; volt>11500; volt-=200) {
      Serial.print(volt);
      Serial.print(F("mv|"));
      for(int discharge=0; discharge<20000; discharge+=2000){
        int soc = estimateStateOfCharge(volt, -discharge);
        Serial.print(soc);
        Serial.print(F("|"));
      }
      Serial.println();
    }
    Serial.println(F("charging table"));
    for(int volt=11300; volt<13000; volt+=200) {
      Serial.print(volt);
      Serial.print(F("v|"));
      for(int charge=0; charge<20000; charge+=2000){
        int soc = estimateStateOfCharge(volt, charge);
        Serial.print(soc);
        Serial.print(F("|"));
      }
      Serial.println();
    }
  }
  updatestateofcharge(0, amperes.converted, voltage.converted);
  if(DEBUG_SETUP) {   
    Serial.print(F("Voltage read = "));
    Serial.println(voltage.converted);
    Serial.print(F("Initial Estimated Battery State of charge = "));
    Serial.println(dischargedAh);
    Serial.print(F("/"));
    Serial.println(batteryCapacityAh);
  }


  addToGraph(amperes, voltage, solarA, solarV);

  if(DEBUG_SETUP) {   
    Serial.println(F("setup() exit"));
  }
}





//the cooperative multitasker... if one of the tasks stall, oh well...
void loop() {
  if(DEBUG_LOOP)
      Serial.println(F("Next loop"));
  if(DEBUG_FREE_MEMORY) {
      Serial.print(F("Free memory="));
      Serial.println(freeMemory());    
  }

  if(isledon)
    digitalWrite(LED_BUILTIN, HIGH);   // turn the LED on (HIGH is the voltage level)
  else
    digitalWrite(LED_BUILTIN, LOW);    // turn the LED off by making the voltage LOW
  isledon=!isledon;
  
  // double check that WIFI is still connected WL_CONNECTED || WL_IDLE_STATUS
  //  show update, when it fails
  if(!isWifiConnected()) {
    if(DEBUG_LOOP)
      Serial.println(F("Wifi lost... attempting to reconnect..."));
    connectToAP();
    // show wifi connection
    if(isWifiConnected()) {
      printWifiStatus();
      // has e-paper display() call, and everyone should have 15 second delay built in

      /*------------NTP UDP, to time servers, receiving response on UDP_RESPONSE_PORT --------------------------*/
      rtc.begin(); 
      Udp2390.begin(UDP_RESPONSE_PORT);
      ntprequest();

      /*------------checking if on internet, or Roadtrip2017 Van --------------------------*/
      configureNetwork();
      
      /*------------NTP listening for requests on port 123 (pretending to be time server)--------------------------*/
      startServerNTP();

      refreshGraph();
    }
    else if(DEBUG_LOOP) {
      Serial.println(F("... unable to reconnect"));
    } else {
      if(uptimeAtAP!=0 && millis()-uptimeAtAP >= 3600000 ) {
        Serial.println(F("... rebooting ..."));
        resetFunc();
      }
    }
  } else {
    // double check time doesnt need updating  
    // Send request to NTP
    //  show update, when it occurs
    if(DEBUG_LOOP) {
      Serial.print(F("Checking clock..."));
      Serial.println(isclockstale() ? F("Stale") : F("OK"));
    }
    if(isclockstale()) { // isWifiConnected() implied
      ntprequest();
      refreshGraph();
    } else if(DEBUG_LOOP) {
      Serial.print(F("Time is "));
      String timestr = formattedlocal(rtcclock());
      Serial.println(timestr);
      timestr.~String();
    }

    // double check that required server is still up every 60 seconds
    //  show update, when it fails
    // Check connectivity to Internet thru website
    //httpRequest();
    //listenToClient();

    if(DEBUG_LOOP) Serial.println(F("checking for HTTP request"));
    httprequesthandle();

    if(DEBUG_LOOP) Serial.println(F("checking for NTP request"));
    handleNTPOn123();
  }

  // Sampling is done on several levels of summation.  Partly to avoid overflow issues
  // L1 is a seconds-long sample of analog readings, averaged and converted to measured units.
  // L2, the L1 samples are reduced it's average and added to the L2 aggregate of samples within either a minute, or whatever the interval is going to be finally
  // L3, the L2 aggregates are added up into the hourly Ah totals, and total uptime Ah totals
  if(DEBUG_LOOP) Serial.println(F("L1 Sampling - or as many samples as possible w/o overflowing the counters"));
  struct analogsamplesum amperes = amperesForWeb = getsample(A1, fudge_for_ammeter2, &ANALOG_VOLT_TO_AMP);
  struct analogsamplesum voltage = voltageForWeb = getsample(A6, fudge_for_voltameter, &ANALOG_VOLT_TO_12V);
  struct analogsamplesum solarA = solarAmpForWeb = getsample(A2, fudge_for_ammeter, &ANALOG_VOLT_TO_AMP);
  struct analogsamplesum solarV = solarVoltForWeb = getsample(A7, fudge_for_voltameter, &ANALOG_VOLT_TO_18V);
  debugginglongSolarA += solarA.converted;
  //absAmpReading(&solarA);
  solarAmpForWeb = solarA;

  //...
  // no real worry about overflow here.
  // this is just to determine the true zero reading level
  // when a current is actually detected, this will be meaningless, and ever-overflowing.
  debugginglongtermA += amperes.converted;
  debugginglongtermCount ++;
  //...

  if(DEBUG_BATT_AMP_SAMPL) Serial.println("amp sample=" + String(amperes.converted) + ", from volts=" + String(amperes.tovolts) + ", readings=" + String(amperes.avg));
  if(DEBUG_BATT_VOLT_SAMPL) Serial.println("volt sample=" + String(voltage.converted) + ", from volts=" + String(voltage.tovolts) + ", readings=" + String(voltage.avg));
  if(DEBUG_SOL_AMP_SAMPL) Serial.println("sol amp sample=" + String(solarA.converted) + ", from volts=" + String(solarA.tovolts) + ", readings=" + String(solarA.avg));
  if(DEBUG_SOL_VOLT_SAMPL) Serial.println("sol volt sample=" + String(solarV.converted) + ", from volts=" + String(solarV.tovolts) + ", readings=" + String(solarV.avg));
  
  if(DEBUG_LOOP) Serial.println(F("Check if Aggregating L2 into L3 and L2 reset"));
  bool rollover = false;
  if(millis() - samplesetMillis > 60000 * MIN_PER_GRAPH_PX) {
    if(DEBUG_LOOP) Serial.println("New sample set old samplesetMillis =" + String(samplesetMillis));
    rollover = true;
    if(validclock()) { // we want samplesetMilliss to reset on the minute hand of clock
      samplesetMillis = millis();
      struct utcdatetime now = rtcclock();
      samplesetMillis -= now.second*1000;
      if(DEBUG_LOOP) Serial.println("...new L2 sample interval start/id by rtc =" + String(samplesetMillis));
      if(millis() - nowAhMillis > nowAhInterval) {
        nowAhMillis = samplesetMillis - now.minute*60000; //minute should always be zero
        long netah = (nowAh/nowAhCount)*(nowAhInterval/1000)/3600; // the weird division is to avoid overflow, so we multiply by a smaller interval
        totalAh+=netah; 
        nowAh=0;
        nowAhCount=0;
        nowAhInterval = 3600000;

        //if(totalAh>maxAh) {
        //  maxAh = totalAh;
        //  sinceMaxAh = 0;
        //}
        int hr = now.hour;
        if(now.minute<15)
          hr = (hr+23)%24;
        struct aggregate *bin = &hourlyAmpSum[hr]; //using time to determine bin
        //struct analogsamplesum *bin = &hourlyAmpSum[graphdatahead/6]; //using the graph to determine bin, always 
        autoadd2(bin, netah); 
        if(DEBUG_LOOP) {
          Serial.println("hourly sum updated");
          for(int i=0; i>24; i++){
            Serial.print(i);
            Serial.print("H f(");
            Serial.print(hourlyAmpSum[i].sum);
            Serial.print("/ ");
            Serial.print(hourlyAmpSum[i].count);
            Serial.print(") =");
            Serial.println(hourlyAmpSum[i].converted);
          }
        }
        
        if(DEBUG_LOOP) Serial.println(F("on the hour, sending http to GPSD/WEBSERVER connectivity notification"));
        char test[] = "/heartbeat.txt";
        httpRequest(VANPI_WEB_SERVER, test, VANPI_WEB_PORT, 0);
        
      } //if(millis() - nowAhMillis > nowAhInterval) // 
      if(totalAhDatetime.epoch==0) {
        totalAhDatetime = now;
        totalAhDatetime.epoch -= millis()/1000; //hopefully it doesn't take 50 days after startup to connect to NTP
      }
    } else {
      unsigned long now = millis();
      unsigned long fraction = (now-samplesetMillis)%60000;
      samplesetMillis = now - fraction;
      if(DEBUG_LOOP) Serial.println("...new L2 sample interval start/id by millis() =" + String(samplesetMillis));
      if(millis() - nowAhMillis > nowAhInterval) {
        nowAhMillis = samplesetMillis;
        long netah = (nowAh/nowAhCount)*(nowAhInterval/1000)/3600; // the weird division is to avoid overflow, so we multiply by a smaller interval
        totalAh+=netah;
        nowAh=0;
        nowAhCount=0;
        nowAhInterval = 3600000;
        
        struct aggregate *bin = &hourlyAmpSum[now/36000000];
        autoadd2(bin, netah);
        if(DEBUG_LOOP) {
          Serial.println("hourly sum updated");
          for(int i=0; i>24; i++){
            Serial.print(i);
            Serial.print("H f(");
            Serial.print(hourlyAmpSum[i].sum);
            Serial.print("/ ");
            Serial.print(hourlyAmpSum[i].count);
            Serial.print(") =");
            Serial.println(hourlyAmpSum[i].converted);
          }
        }
      }
    } //if(millis() - samplesetMillis > 60000 * MIN_PER_GRAPH_PX) // if graph pixel has elapsed


    // keep track of this hour's amperage samples to produce an average at end of hour.
    // no need to do integration.  The sample interval is an hour, so the average value is same as area under sample curve. 
    nowAh += amperesMinuteTot.converted; //L2 average totalled and incremented.
    nowAhCount++;

    // update battery charge/discharge
    // you need to make this an average
    if(sampleStartMillis!=0) {
      unsigned long sampleInterval = millis() - sampleStartMillis;
      long sampleAh = (long)amperesMinuteTot.converted * (long)sampleInterval/3600000L;
      // long netah = (nowAh/nowAhCount)*(nowAhInterval/1000)/3600; // the weird division is to avoid overflow, so we multiply by a smaller interval
      if(sampleInterval%3600000 >= 1800000)
          sampleAh++; //round up
      if(DEBUG_LOOP) {
        Serial.print("before discharged mAh=");
        Serial.println(dischargedAh);
      }
      //updatestateofcharge(sampleAh, amperes.converted, voltage.converted);
      if(DEBUG_LOOP) {
        Serial.print("Sample interval=");
        Serial.println(sampleInterval);
        Serial.print("recorded mA=");
        Serial.println(amperesMinuteTot.converted);
        Serial.print("calculated mAh=");
        Serial.println(sampleAh);
      }
    }
    sampleStartMillis = millis();

    
    //addToGraph(amperes, voltage);
    addToGraph(amperesMinuteTot, voltageMinuteTot, solarMinuteTotA, solarMinuteTotV);
    
    zeroOut(&amperesMinuteTot);
    zeroOut(&voltageMinuteTot);
    zeroOut(&solarMinuteTotA);
    zeroOut(&solarMinuteTotV);
  } //if(millis() - samplesetMillis > 60000 * MIN_PER_GRAPH_PX)

  if(DEBUG_BATT_AMP_SAMPL) {
    Serial.println(F("Ah calculation parts below:"));
    Serial.println("1.existing aggregate, sum=" + String(amperesMinuteTot.sum) + " count=" + String(amperesMinuteTot.count) + " avg=" + String(amperesMinuteTot.avg) + " volts=" + String(amperesMinuteTot.tovolts) + " measured=" + String(amperesMinuteTot.converted));
    Serial.println("2.new sample, sum=" + String(amperes.sum) + " count=" + String(amperes.count) + " avg=" + String(amperes.avg) + " volts=" + String(amperes.tovolts) + " measured=" + String(amperes.converted));
  }
  if(DEBUG_LOOP) Serial.println(F("Aggregating L1 Samples into L2"));

  //Serial.println("count before=" + String(solarMinuteTotV.count));
  //Serial.println("sum before=" + String(solarMinuteTotV.sum));
  //Serial.println("addend before=" + String(solarV.avg));

  if(MIN_PER_GRAPH_PX*DATA_COUNT>sample_count) { 
    //this will have effect of lowering the weight of the earlier readings, and twice more weight on the later half of readings.
    if(amperesMinuteTot.count>=sample_count) reduceToAvg(&amperesMinuteTot);
    if(voltageMinuteTot.count>=sample_count) reduceToAvg(&voltageMinuteTot);
    if(solarMinuteTotA.count>=sample_count) reduceToAvg(&solarMinuteTotA);
    if(solarMinuteTotV.count>=sample_count) reduceToAvg(&solarMinuteTotV);
    
    //(a+b+c+d+...+z)/n    sum/count
    //sum+sum+sum/count+count+count = and sum already is going to overflow
  }
  inclInAvg(&amperesMinuteTot, amperes);
  inclInAvg(&voltageMinuteTot, voltage);
  inclInAvg(&solarMinuteTotA, solarA);
  inclInAvg(&solarMinuteTotV, solarV);

  

  //Serial.println("count after=" + String(solarMinuteTotV.count));
  //Serial.println("sum after=" + String(solarMinuteTotV.sum));
  if(DEBUG_SAMPLING) {
    Serial.println("new aggregate, sum=" + String(amperesMinuteTot.sum) + " count=" + String(amperesMinuteTot.count) + " avg=" + String(amperesMinuteTot.avg) + " volts=" + String(amperesMinuteTot.tovolts) + " measured=" + String(amperesMinuteTot.converted));
    Serial.println();
  }
  if(DEBUG_BATT_AMP_SAMPL) Serial.println("amp for this min/L2=" + String(amperesMinuteTot.converted));
  if(DEBUG_BATT_VOLT_SAMPL) Serial.println("volt for this min/L2=" + String(voltageMinuteTot.converted));
  if(DEBUG_SOL_AMP_SAMPL) Serial.println("solar amp for this min/L2=" + String(solarMinuteTotA.converted));
  if(DEBUG_SOL_VOLT_SAMPL) Serial.println("solar volt for this min/L2=" + String(solarMinuteTotV.converted));
  if(DEBUG_BATT_AMP_SAMPL) {
    Serial.print("amp-hour drift/reading, if on zero amps the entire uptime, is:");
    Serial.println(debugginglongtermA/debugginglongtermCount);
  }
  if(DEBUG_SOL_AMP_SAMPL) {
    Serial.print("sol amp-hour drift/reading, if on zero amps the entire uptime, is:");
    Serial.println(debugginglongSolarA/debugginglongtermCount);
  }
  if(DEBUG_FREE_MEMORY) {
      Serial.print(F("End of loop() Free memory="));
      Serial.println(freeMemory());
      unsigned long ms = millis();
      String newobjref = String(ms);
      Serial.print(F("address of last newly allocated string="));
      Serial.println((unsigned int)&newobjref);
      const char* newobjref2 = newobjref.c_str();      
      Serial.print(F("address of last newly allocated c_string="));
      Serial.println((unsigned int)newobjref2);
      // https://stackoverflow.com/questions/8843604/string-c-str-deallocation-necessary
      //meaning newobjref2 just points to memory alloc'ed by String().  So when it goes out of scope, the pointer might point to invalid data used by some other object bc it was marked as released, is what I think they mean.
      Serial.print(F("address of long variable that should be allocated on stack="));
      Serial.println((unsigned int)&ms);
      // https://learn.adafruit.com/memories-of-an-arduino/optimizing-sram
      // see memory management tips and why I output the address of variable allocated on stack, and one I think should be on heap
      // I'm of course assuming no virtual memory translation shananigans, that an modern multitasking operating system implements
  }
  if(DEBUG_LOOP)
    Serial.println(F("loop() complete"));  
}

void absAmpReading(struct analogsamplesum *ampreading) {
  long zeroampreading = (1676-ampreading->calibrate)*4095/3300+1;
  long zeroampreadingmult = ampreading->count*zeroampreading;
  long diff = zeroampreadingmult - ampreading->sum;
  long delta = abs(diff);
  long reext = zeroampreadingmult+delta;

  ampreading->sum = reext;

  computesampleAvg(ampreading);
  computesampleVolts(ampreading);
  computesampleConversion(ampreading);
}

unsigned long rtcMinuteMillis() {
  unsigned long ms = millis();
  struct utcdatetime now = rtcclock();
  ms -= now.second*1000;
  return ms;
}
unsigned long uptimeMinuteMillis() {
  //unsigned long ms = millis();
  //unsigned long fraction = (ms-samplesetMillis)%60000;
  //ms = ms - fraction;
  return millis()%60000;
}
unsigned int rtcPrevHour(){
  return (rtcclock().hour+23)%24;
}
unsigned int rtcNowHour(){
  return rtcclock().hour;
}
unsigned int uptimePrevHour(){
  return ((millis()%86400000)+23)%24;
}
unsigned int uptimeNowHour(){
  return (millis()%86400000)/3600000;
}

void startupdraw(){

  epd.clearBuffer();
  //epd.fillScreen(EPD_BLACK);
  //250x122
  unsigned int w = epd.width()-1;
  unsigned int h = epd.height()-1;
  unsigned int x = millis() % 40;
  unsigned int y = millis() % 20;

  //fills
  epd.fillRect(x, y, w-42, h-22, EPD_BLACK);
  epd.fillRect(x, y, w-42, h-22, EPD_INVERSE);
  epd.drawRect(x+2, y+2, w-46, h-26, EPD_BLACK);

  //shapes
  epd.drawLine(50+w/3 + millis() % w/2, h/3 + millis() % h/2, millis() % w/2, millis() % h/2, EPD_BLACK);

  epd.drawFastHLine(50+millis() % h, millis() % w, millis() % w, EPD_BLACK);
  epd.drawFastVLine(50+millis() % w, millis() % h, millis() % h, EPD_BLACK);

// useless, EPD_WHITE has no routine handling it, in drawPixel()
//  epd.drawFastHLine(millis() % h, millis() % w, millis() % w, EPD_WHITE);
//  epd.drawFastVLine(millis() % w, millis() % h, millis() % h, EPD_WHITE);

//  epd.fillCircle(2*millis() % h/3, 2*millis() % w/3, millis() % w/4, EPD_WHITE);
//  epd.drawCircle(2*millis() % h/3, 2*millis() % w/3, millis() % w/4, EPD_WHITE);
  //epd.fillCircle(2*millis() % h/3, 2*millis() % w/3, millis() % w/4, EPD_BLACK);
  epd.fillCircle(50, 20, 75, EPD_BLACK);
  epd.drawCircle(50+2*millis() % h/3, 2*millis() % w/3, millis() % w/4, EPD_BLACK);

  //outline text
  epd.setCursor(19,4);
  epd.setTextColor(EPD_BLACK);
  epd.print(F("Lorem ipsum dolor sit amet"));
  epd.setCursor(19,4);
  epd.setTextColor(EPD_INVERSE);
  epd.print(F("Lorem ipsum dolor sit amet"));
  
  epd.setCursor(21,4);
  epd.setTextColor(EPD_BLACK);
  epd.print(F("Lorem ipsum dolor sit amet"));
  epd.setCursor(21,4);
  epd.setTextColor(EPD_INVERSE);
  epd.print(F("Lorem ipsum dolor sit amet"));
  
  epd.setCursor(21,6);
  epd.setTextColor(EPD_BLACK); 
  epd.print(F("Lorem ipsum dolor sit amet"));
  epd.setCursor(21,6);
  epd.setTextColor(EPD_INVERSE);
  epd.print(F("Lorem ipsum dolor sit amet"));
  
  epd.setCursor(19,6);
  epd.setTextColor(EPD_BLACK);
  epd.print(F("Lorem ipsum dolor sit amet"));
  epd.setCursor(19,6);
  epd.setTextColor(EPD_INVERSE);
  epd.print(F("Lorem ipsum dolor sit amet"));

  epd.setCursor(20,5);
  epd.setTextColor(EPD_BLACK);
  epd.print(F("Lorem ipsum dolor sit amet"));

  //title
  //epd.drawRoundRect(w/2 + millis() % w/2, h/2 + millis() % h/2, millis() % w/2, millis() % h/2, EPD_BLACK);
  epd.fillRect(50, 100, 150, 20, EPD_BLACK);
  epd.setCursor(60,106);
  epd.setTextColor(EPD_INVERSE);
  char v[] = "Version:                ";
  updateCStr(v,9,14,VERSION);
  epd.print(v);

  epd.setCursor(20,24);
  epd.setTextColor(EPD_INVERSE);
  epd.print(F("Arduino Nano 33 IoT Auto Power Meter\nFeatures:\n-Wifi Access\n-Voltage Graphing\n-Amp Graphing\n-NTP Time Server\n-Web Server 24hr Data"));

  if(DEBUG_FREE_MEMORY) {
      Serial.print(F("End of Splash startupdraw() Free memory="));
      Serial.println(freeMemory());    
  }

  
  epd.display();
  delay(15000);
}


// This function opens a Windows Bitmap (BMP) file and
// displays it at the given coordinates.  It's sped up
// by reading many pixels worth of data at a time
// (rather than pixel by pixel).  Increasing the buffer
// size takes more of the Arduino's precious RAM but
// makes loading a little faster.  20 pixels seems a
// good balance.

// There are 2 BMP draw functions... this one is provided by ADAfruit and can read BMP from SD Card
// It will read a 24bit RGB type BMP, drawwing the image straight to Image buffer, just using a few bytes in array to speed reads thru block reads.
// The other is at bottom of this file, and primarily is focused on decoding 1bpp monochrome BMP's, 
//   which are implicitly compressed (though marked as uncompressed RBG) as 8 pixels per byte.
// The bottom method takes an array of char to transfer the entire copy to image buffer (via EPD.draw???? methods).

#define BUFFPIXEL 20

bool bmpDraw(char *filename, int16_t x, int16_t y) {

  File     bmpFile;
  int      bmpWidth, bmpHeight;   // W+H in pixels
  uint8_t  bmpDepth;              // Bit depth (currently must be 24)
  uint32_t bmpImageoffset;        // Start of image data in file
  uint32_t rowSize;               // Not always = bmpWidth; may have padding
  uint8_t  sdbuffer[3*BUFFPIXEL]; // pixel buffer (R+G+B per pixel)
  uint8_t  buffidx = sizeof(sdbuffer); // Current position in sdbuffer
  boolean  goodBmp = false;       // Set to true on valid header parse
  boolean  flip    = true;        // BMP is stored bottom-to-top
  int      w, h, row, col, x2, y2, bx1, by1;
  uint8_t  r, g, b;
  uint32_t pos = 0, startTime = millis();

  if((x >= epd.width()) || (y >= epd.height())) return false;

  Serial.println();
  Serial.print(F("Loading image '"));
  Serial.print(filename);
  Serial.println('\'');

  // Open requested file on SD card
  if ((bmpFile = SD.open(filename)) == NULL) {
    Serial.print(F("File not found"));
    return false;
  }

  // Parse BMP header
  if(read16(bmpFile) == 0x4D42) { // BMP signature
    Serial.print(F("File size: ")); Serial.println(read32(bmpFile));
    (void)read32(bmpFile); // Read & ignore creator bytes
    bmpImageoffset = read32(bmpFile); // Start of image data
    Serial.print(F("Image Offset: ")); Serial.println(bmpImageoffset, DEC);
    // Read DIB header
    Serial.print(F("Header size: ")); Serial.println(read32(bmpFile));
    bmpWidth  = read32(bmpFile);
    bmpHeight = read32(bmpFile);
    if(read16(bmpFile) == 1) { // # planes -- must be '1'
      bmpDepth = read16(bmpFile); // bits per pixel
      Serial.print(F("Bit Depth: ")); Serial.println(bmpDepth);
      if((bmpDepth == 24) && (read32(bmpFile) == 0)) { // 0 = uncompressed

        goodBmp = true; // Supported BMP format -- proceed!
        Serial.print(F("Image size: "));
        Serial.print(bmpWidth);
        Serial.print('x');
        Serial.println(bmpHeight);

        // BMP rows are padded (if needed) to 4-byte boundary
        rowSize = (bmpWidth * 3 + 3) & ~3;

        // If bmpHeight is negative, image is in top-down order.
        // This is not canon but has been observed in the wild.
        if(bmpHeight < 0) {
          bmpHeight = -bmpHeight;
          flip      = false;
        }

        // Crop area to be loaded
        x2 = x + bmpWidth  - 1; // Lower-right corner
        y2 = y + bmpHeight - 1;
        if((x2 >= 0) && (y2 >= 0)) { // On screen?
          w = bmpWidth; // Width/height of section to load/display
          h = bmpHeight;
          bx1 = by1 = 0; // UL coordinate in BMP file
  
          for (row=0; row<h; row++) { // For each scanline...
  
            // Seek to start of scan line.  It might seem labor-
            // intensive to be doing this on every line, but this
            // method covers a lot of gritty details like cropping
            // and scanline padding.  Also, the seek only takes
            // place if the file position actually needs to change
            // (avoids a lot of cluster math in SD library).
            if(flip) // Bitmap is stored bottom-to-top order (normal BMP)
              pos = bmpImageoffset + (bmpHeight - 1 - (row + by1)) * rowSize;
            else     // Bitmap is stored top-to-bottom
              pos = bmpImageoffset + (row + by1) * rowSize;
            pos += bx1 * 3; // Factor in starting column (bx1)
            if(bmpFile.position() != pos) { // Need seek?
              bmpFile.seek(pos);
              buffidx = sizeof(sdbuffer); // Force buffer reload
            }
            for (col=0; col<w; col++) { // For each pixel...
              // Time to read more pixel data?
              if (buffidx >= sizeof(sdbuffer)) { // Indeed
                bmpFile.read(sdbuffer, sizeof(sdbuffer));
                buffidx = 0; // Set index to beginning
              }
              // Convert pixel from BMP to EPD format, push to display
              b = sdbuffer[buffidx++];
              g = sdbuffer[buffidx++];
              r = sdbuffer[buffidx++];

              uint8_t c = 0;
              if ((r < 0x80) && (g < 0x80) && (b < 0x80)) {
                 c = EPD_BLACK; // try to infer black
              } else if ((r >= 0x80) && (g >= 0x80) && (b >= 0x80)) {
                 c = EPD_WHITE;
              } else if (r >= 0x80) {
                c = EPD_RED; //try to infer red color
              }
              
              epd.writePixel(col, row, c);
            } // end pixel
          } // end scanline
        } // end onscreen
        epd.display();
        Serial.print(F("Loaded in "));
        Serial.print(millis() - startTime);
        Serial.println(" ms");
      } // end goodBmp
    }
  }

  bmpFile.close();
  if(!goodBmp) {
    Serial.println(F("BMP format not recognized."));
    return false;
  }
  return true;
}

void drawTextAsBlips(int left, int top, char* text, int startindex, int endindex) {
  unsigned int x=0;
  unsigned int y=0;
//  unsigned int len = text.length();
  for(unsigned int i=startindex; i<endindex; i++)
  {
    char ch = text[i];
    if(ch>=33 && ch<127) { //visible letters 
      epd.drawPixel(x + left,y+top,EPD_BLACK);
      x++;
    } else if(ch=='\n') {
      x=0;
      y++;
    } else if(ch==' ')
      x++;
  }
  /*
  epd.setCursor(50, 70);
  epd.setTextColor(EPD_INVERSE);
  epd.print("--Web");
  epd.display();
  
  delay(15000);*/
}

// These read 16- and 32-bit types from the SD card file.
// BMP data is stored little-endian, Arduino is little-endian too.
// May need to reverse subscript order if porting elsewhere.

uint16_t read16(File &f) {
  uint16_t result;
  ((uint8_t *)&result)[0] = f.read(); // LSB
  ((uint8_t *)&result)[1] = f.read(); // MSB
  return result;
}

uint32_t read32(File &f) {
  uint32_t result;
  ((uint8_t *)&result)[0] = f.read(); // LSB
  ((uint8_t *)&result)[1] = f.read();
  ((uint8_t *)&result)[2] = f.read();
  ((uint8_t *)&result)[3] = f.read(); // MSB
  return result;
}


void printDirectory(File dir, int numTabs) {
  while (true) {

    File entry =  dir.openNextFile();
    if (! entry) {
      // no more files
      break;
    }
    for (uint8_t i = 0; i < numTabs; i++) {
      Serial.print('\t');
    }
    Serial.print(entry.name());
    if (entry.isDirectory()) {
      Serial.println("/");
      printDirectory(entry, numTabs + 1);
    } else {
      // files have sizes, directories do not
      Serial.print("\t\t");
      Serial.println(entry.size(), DEC);
    }
    entry.close();
  }
}
void epdDisplayDeferredDelay() {
  if(SAFE_EPD) {
    epd.display();
    delay(15000); //always delay 15seconds after display.  It's not worth the risk to the epaper.
  } else {
    unsigned long span = millis()-lastEPDupdatemillis;
    if(span < 15000) {
      Serial.println("Warning: Epaper delay:" + String(span));
      delay(15000);
    }
    lastEPDupdatemillis = millis();
  }
  epd.display();
}

long lowmem;

#ifdef __arm__
// should use uinstd.h to define sbrk but Due causes a conflict
extern "C" char* sbrk(int incr);
#else  // __ARM__
extern char *__brkval;
#endif  // __arm__
 
int freeMemory() {
  char top;
#ifdef __arm__
  int freem = &top - reinterpret_cast<char*>(sbrk(0));
#elif defined(CORE_TEENSY) || (ARDUINO > 103 && ARDUINO != 151)
  int freem = &top - __brkval;
#else  // __arm__
  int freem = __brkval ? &top - __brkval : &top - __malloc_heap_start;
#endif  // __arm__
  if(lowmem==0 || (freem < lowmem))
    lowmem = freem;
  if(DEBUG_FREE_MEMORY){
      Serial.print(F("(Lowest memory detected="));
      Serial.print(lowmem);    
      Serial.print(")");
  }
  if(freem < 2000) {
    if(DEBUG_FREE_MEMORY) {
      Serial.println(F("Less than 2k detected.  Please examine"));
      Serial.println(freem);
      halt();
    }
  }
  return freem;
}
void halt() {
  pinMode(LED_BUILTIN, OUTPUT);
  while(true) { //halt
    // initialize digital pin LED_BUILTIN as an output.
    digitalWrite(LED_BUILTIN, HIGH);   // turn the LED on (HIGH is the voltage level)
    delay(1000);                       // wait for a second
    digitalWrite(LED_BUILTIN, LOW);    // turn the LED off by making the voltage LOW
    delay(1000);                       // wait for a second
  }
}


void printWifiStatus() {
  // print the SSID of the network you're attached to:
  if(DEBUG_WIFI) {
    Serial.print(F("SSID: "));
    Serial.println(WiFi.SSID());
  }
  
  // print your WiFi shield's IP address:
  IPAddress ip = WiFi.localIP();
  if(DEBUG_WIFI) {
    Serial.print(F("IP Address: "));
    Serial.println(ip);
  }

  // print the received signal strength:
  long rssi = WiFi.RSSI();
  if(DEBUG_WIFI) {
    Serial.print(F("signal strength (RSSI):"));
    Serial.print(rssi);
    Serial.println(F(" dBm"));
  }

  byte mac[6];                     // the MAC address of your Wifi shield
  WiFi.macAddress(mac);

  // Draw some text
  epd.clearBuffer();
  epd.setCursor(0, 10);
  epd.setTextColor(EPD_BLACK);
  epd.setTextSize(2);
  char mesg[] = "SSID:_             \nIP Addr:_              \nSignal(RSSI):    dBm\nMAC:__.__.__.__.__.__\nWeb Server:_        ";
  char *ptr = &mesg[0];
  char old = ' ';
  unsigned int spot = 0;
  String ssid = String(WiFi.SSID());
  String ipaddr = formatIP(ip);
  String sign = String(rssi);
  String websvr = webserver.status()==1 ? trueToStr : falseToStr;
  updateCStr(ptr, 5, 14, ssid);
  updateCStr(ptr, 28, 15, ipaddr);
  updateCStr(ptr, 57, 6, sign);
  //updateCStr(ptr, 70, 13, websvr);
  puthexInCStr(ptr,mac[5],69);
  puthexInCStr(ptr,mac[4],72);
  puthexInCStr(ptr,mac[3],75);
  puthexInCStr(ptr,mac[2],78);
  puthexInCStr(ptr,mac[1],81);
  puthexInCStr(ptr,mac[0],84);
  updateCStr(ptr, 98, 7, websvr);
  mesg[sizeof(mesg)-1] = 0;
  //String mesg = "SSID:" + String(WiFi.SSID()) + "\nIP Addr:" + formatIP(ip)+ "\nSignal(RSSI):" + String(rssi) + "dBm\n\nWeb Server:" + String(webserver.status());
  epd.print(mesg);
  epd.display();
  ipaddr.~String();

  epd.setTextSize(1);
  delay(15000);
}
String formatIP(IPAddress ip) {
  String byt1 = String(ip[0]);
  String byt2 = String(ip[1]);
  String byt3 = String(ip[2]);
  String byt4 = String(ip[3]);
  
  String formatted = byt1 + dotToStr + byt2 + dotToStr + byt3 + dotToStr + byt4;

  //for the day, when memory leaks are so bad, I need to remove all the references to string, just as a rule out, that it is cause of the fragmentation - which I don't under why initializing all the functions at start, doesn't solve.  I don't store strings anywhere in global variables.  It should all be collected moving up and down the stack.
  //char dot[] = ".";
  //char format[] = "0.0.0.0        "; //actually a buffer, but having the format there, is self documenting
  //char* ptr = &format[0];
  //ptr+=putnumInCStr(format, ip[0], 0);
  //ptr++[0] = '.';
  //ptr+=putnumInCStr(format, ip[1], 0);
  //ptr++[0] = '.';
  //ptr+=putnumInCStr(format, ip[2], 0);
  //ptr++[0] = '.';
  //ptr+=putnumInCStr(format, ip[3], 0);
  //return String(format);
  
  return formatted;
}
unsigned int updateCStr(char* toupdate, unsigned int at, unsigned int mx, String with) {
  toupdate+=at;
  unsigned int spot = with.length();
  char old = toupdate[spot];
  with.toCharArray(toupdate, mx); //5
  toupdate[spot] = old; //assuming this is where it places a null character

  return spot;
}
// https://arduino.stackexchange.com/questions/42986/convert-int-to-char
unsigned int putnumInCStr(char* toupdate, int num, unsigned int at) {
  toupdate += at;

  int copy;
  unsigned int spot=0;
  if(copy!=0)
    while(copy!=0) {
      spot++;
      copy/=10;
    }
  else
    spot=1;
  spot++;
  char old = toupdate[spot];
  
  char* val = itoa(num,toupdate,10);
  if(val==0)
    return 0;
  if(toupdate[spot]==0)
    toupdate[spot] = old;

  return spot;
}
unsigned int puthexInCStr(char* toupdate, int num, unsigned int at) {
  toupdate+=at;

  int copy;
  unsigned int spot=0;
  if(copy!=0)
    while(copy!=0) {
      spot++;
      copy/=16;
    }
  else
    spot=1;
  spot++;
  char old = toupdate[spot];
  
  char* val = itoa(num,toupdate,16);
  if(val==0)
    return 0;
  if(toupdate[spot]==0)
    toupdate[spot] = old;

  return spot;
}

void connectToAP() {
  status = WiFi.status();
  if(DEBUG_WIFI) {
    Serial.print(F("Current Wifi status code="));
    Serial.print(status);
    Serial.println();
  }
  
  // check for the presence of the shield:
  if (status == WL_NO_SHIELD) {
    if(DEBUG_WIFI) Serial.println(F("WiFi shield not present"));
    // don't continue:
    //while (true); //Bob - not bothering to abort.  Anything that uses network, needs to checl
  }

  // attempt to connect to Wifi network:
  int retries = 5;
  while ( status != WL_CONNECTED && (retries--)>0) {  //Bob - added a limit of 5 retries, then move on.  No wifi, no big deal.
    if(DEBUG_WIFI) {
      Serial.print(F("Attempting to connect to SSID: "));
      Serial.println(SECRET_SSID);
    }
    // Connect to WPA/WPA2 network. Change this line if using open or WEP network:
    status = WiFi.begin(SECRET_SSID, SECRET_PASS);

    // wait 1 second for connection:
    delay(1000);
  }
  //if(isWifiConnected())
  //  webserver.begin();
  if(isWifiConnected())
    uptimeAtAP = millis();

  if(DEBUG_FREE_MEMORY) {
      Serial.print(F("End of connectToAP() Free memory="));
      Serial.println(freeMemory());    
  }
}
bool isWifiConnected() {
  int last = WiFi.status();
  return (last == WL_CONNECTED); // || (last == WL_IDLE_STATUS);
}



void httprequesthandle() {
  // listen for incoming clients
  WiFiClient tcpconnect = webserver.available();
  if (tcpconnect) {
    if(DEBUG_HTTP_INCOMING) Serial.println(F("new client"));
    
    /*
    // an http request ends with a blank line
    boolean currentLineIsBlank = true;
    while (tcpconnect.connected()) {
      if (tcpconnect.available()) {
        char c = tcpconnect.read();
        Serial.write(c);
        // if you've gotten to the end of the line (received a newline
        // character) and the line is blank, the http request has ended,
        // so you can send a reply
        if (c == '\n' && currentLineIsBlank) {
          // send a standard http response header
          tcpconnect.println("HTTP/1.1 200 OK");
          tcpconnect.println("Content-Type: text/html");
          tcpconnect.println("Connection: close");  // the connection will be closed after completion of the response
          //tcpconnect.println("Refresh: 5");  // refresh the page automatically every 5 sec
          tcpconnect.println();
          tcpconnect.println("<!DOCTYPE HTML>");
          tcpconnect.println("<html>");
          tcpconnect.println(formattedlocal(rtcclock()));
          // output the value of each analog input pin
          for (int analogChannel = 0; analogChannel < 6; analogChannel++) {
            int sensorReading = analogRead(analogChannel);
            tcpconnect.print("analog input ");
            tcpconnect.print(analogChannel);
            tcpconnect.print(" is ");
            tcpconnect.print(sensorReading);
            tcpconnect.println("<br />");
          }
          tcpconnect.println("</html>");
          break;
        }
        if (c == '\n') {
          // you're starting a new line
          currentLineIsBlank = true;
        } else if (c != '\r') {
          // you've gotten a character on the current line
          currentLineIsBlank = false;
        }
      }
    }
    */
    if(tcpconnect.connected()) {
      String raw = serverrequest(tcpconnect);
      String line1 = httprequestline(raw);
      String methodcode = String(httpmethod(line1));
      String uri = httprequesturi(line1);
      String url = requesturl(uri);
      String query = requestquerystring(uri);

      tcpconnect.println(HTTP1_1_200_OK);
      tcpconnect.println(Content_Type_text_html);
      tcpconnect.println(Connection_close);  // the connection will be closed after completion of the response
      //tcpconnect.println("Refresh: 5");  // refresh the page automatically every 5 sec
      tcpconnect.println();
      tcpconnect.print(HTML_DOCTYPE_HTML);
      tcpconnect.print(HTML_html);
      String timstr = formattedlocal(rtcclock());
      tcpconnect.print(timstr);
      timstr.~String();
      tcpconnect.println(EOL);

      if(url==URL_adc) {
        // output the value of each analog input pin
        for (int analogChannel = 0; analogChannel < 8; analogChannel++) {
          int sensorReading = analogRead(analogChannel);
          tcpconnect.print(analog_input);
          tcpconnect.print(analogChannel);
          tcpconnect.print(_is_);
          tcpconnect.print(sensorReading);
          tcpconnect.println(EOL);
        }
      } else if(url==URL_live) {
          tcpconnect.println(Timestamp_Category_Value_Units_tag_eor);
          String now = formattedlocal(rtcclock());          
          struct analogsamplesum voltage = getsample(A6, fudge_for_voltameter, &ANALOG_VOLT_TO_12V);
          tcpconnect.print(now);
          tcpconnect.print(_SystemVoltage_);
          tcpconnect.print(voltage.converted);
          tcpconnect.print(milli_);
          tcpconnect.print(voltage.converter->units);
          tcpconnect.println(EOR);
          
          struct analogsamplesum amperes = getsample(A1, fudge_for_ammeter2, &ANALOG_VOLT_TO_AMP);          
          tcpconnect.print(now);
          tcpconnect.print(_BatteryRate_);
          tcpconnect.print(amperes.converted);
          tcpconnect.print(milli_);
          tcpconnect.print(amperes.converter->units);
          tcpconnect.println(EOR);

          long ah = getUptimeNetBatteryAh();
          tcpconnect.print(now);
          tcpconnect.print(_BatteryNetCharge_);
          tcpconnect.print(ah);
          tcpconnect.print(milli_);
          tcpconnect.print(amperes.converter->units);
          tcpconnect.println(EOR);

          struct analogsamplesum solarstatus = getsample(A7, fudge_for_voltameter, &ANALOG_VOLT_TO_18V);
          tcpconnect.print(now);
          tcpconnect.print(F(",SolarStatus,"));
          tcpconnect.print(solarstatus.converted);
          tcpconnect.print(milli_);
          tcpconnect.print(solarstatus.converter->units);
          tcpconnect.println(EOR);
          
          struct analogsamplesum solarsupply = getsample(A2, fudge_for_ammeter, &ANALOG_VOLT_TO_AMP);
          tcpconnect.print(now);
          tcpconnect.print(_SolarSupply_);
          tcpconnect.print(solarsupply.converted);
          tcpconnect.print(milli_);
          tcpconnect.print(solarsupply.converter->units);
          tcpconnect.println(EOR);

          now.~String();

      } else if(url==URL_powermeter) {
          tcpconnect.println(Timestamp_Category_Value_Units_tag_eor);
          String now = formattedlocal(rtcclock());          
          tcpconnect.print(now);
          tcpconnect.print(_SystemVoltage_);
          tcpconnect.print(voltageForWeb.converted);
          tcpconnect.print(milli_);
          tcpconnect.print(voltageForWeb.converter->units);
          tcpconnect.println(EOR);
          
          tcpconnect.print(now);
          tcpconnect.print(_BatteryRate_);
          tcpconnect.print(amperesForWeb.converted);
          tcpconnect.print(milli_);
          tcpconnect.print(amperesForWeb.converter->units);
          tcpconnect.println(EOR);

          long ah = getUptimeNetBatteryAh();
          tcpconnect.print(now);
          tcpconnect.print(_BatteryNetCharge_);
          tcpconnect.print(ah);
          tcpconnect.print(_mAh);
          tcpconnect.println(EOR);

          tcpconnect.print(now);
          tcpconnect.print(_SolarStatus_);
          tcpconnect.print(solarVoltForWeb.converted);
          tcpconnect.print(milli_);
          tcpconnect.print(solarVoltForWeb.converter->units);
          tcpconnect.println(EOR);
          
          tcpconnect.print(now);
          tcpconnect.print(_SolarSupply_);
          tcpconnect.print(solarAmpForWeb.converted);
          tcpconnect.print(milli_);
          tcpconnect.print(solarAmpForWeb.converter->units);
          tcpconnect.println(EOR);

          long trueCapacityAh = batteryCapacityAh - lostCapacityAh;
          long availCapacityAh = trueCapacityAh+dischargedAh;
          tcpconnect.print(now);
          tcpconnect.print(_EstFullCapacity_);
          tcpconnect.print(trueCapacityAh);
          tcpconnect.print(_mAh);
          tcpconnect.println(EOR);

          tcpconnect.print(now);
          tcpconnect.print(_EstAvailCapacity_);
          tcpconnect.print(availCapacityAh);
          tcpconnect.print(_mAh);
          tcpconnect.println(EOR);

          now.~String();
      } else if(url==URL_powerhistory) {
        tcpconnect.println(Timestamp_BatteryAmp_SystemVoltage_SolarStatus_SolarSupply_eor);
        for (int i = 0; i< DATA_COUNT; i++) {
          int index = (graphdatahead+i) % DATA_COUNT;
          tcpconnect.print(readings[index].utc.epoch);
          tcpconnect.print(TEXT_COMMA);
          tcpconnect.print(readings[index].batterymA);
          tcpconnect.print(TEXT_COMMA);
          tcpconnect.print(readings[index].batterymV);
          tcpconnect.print(TEXT_COMMA);
          tcpconnect.print(readings[index].solarmA);
          tcpconnect.print(TEXT_COMMA);
          tcpconnect.print(readings[index].solarmV);
          tcpconnect.println(EOR);
        }
      } else if(url==URL_hourly) {
        tcpconnect.println(hourUTC_hourlocal_batterynet_eor);
        for (int i = 0; i < 24; i++) {
          tcpconnect.print(i);
          tcpconnect.print(TEXT_COMMA);
          tcpconnect.print((i+tz+24) % 24); // we are not reflecting partial hours b/c we can't divide the array into partials
          tcpconnect.print(TEXT_COMMA);
          tcpconnect.print(hourlyAmpSum[i].avg);
          tcpconnect.print(TEXT_COMMA);
          tcpconnect.print(hourlyAmpSum[i].sum);
          tcpconnect.print(TEXT_COMMA);
          tcpconnect.print(hourlyAmpSum[i].count);
          tcpconnect.print(TEXT_COMMA);
          tcpconnect.print(hourlyAmpSum[i].mx);
          tcpconnect.print(TEXT_COMMA);
          tcpconnect.print(hourlyAmpSum[i].mn);

          tcpconnect.println(EOR);
        }
      } else if(url==URL_ntp) {
        // show time of boot
        tcpconnect.print(First_NTP_sync_epoch_);
        tcpconnect.print(datetimeAtConnect.epoch);
        tcpconnect.println(EOR);
        
        // last NTP sync
        tcpconnect.print(Local_time_of_last_outgoing_NTP_sync_request_);
        String timestr = formattedlocal(datetimeAtNTP);
        tcpconnect.print(timestr);
        timestr.~String();
        tcpconnect.println(EOL);
        tcpconnect.print(Unix_Epoch_calculated_from_incoming_response_from_NTP_);
        tcpconnect.print(datetimeAtNTP.epoch);
        tcpconnect.println(EOR);

        // last NTP request
        tcpconnect.print(Last_outgoing_NTP_sync_response_sent_to_IP_);
        tcpconnect.print(lastremoteip[0]);
        tcpconnect.print(TEXT_PERIOD);
        tcpconnect.print(lastremoteip[1]);
        tcpconnect.print(TEXT_PERIOD);
        tcpconnect.print(lastremoteip[2]);
        tcpconnect.print(TEXT_PERIOD);
        tcpconnect.print(lastremoteip[3]);
        tcpconnect.println(EOL);
        tcpconnect.print(Last_outgoing_NTP_sync_response_sent_epoch_value_);
        tcpconnect.print(lastremoteepoch);
        tcpconnect.println(EOL);
        tcpconnect.print(Number_of_NTP_requests_served_);
        tcpconnect.print(ntpscount);
        tcpconnect.println(EOR);
        
        // drift adjustments
        tcpconnect.print(Adjustments_to_RTC_actual_elapsed_);
        tcpconnect.print(rtcdrift.A);
        tcpconnect.print(_rtc_elapsed___);
        tcpconnect.print(rtcdrift.Bn);
        tcpconnect.print(F("/"));
        tcpconnect.print(rtcdrift.Bd);
        tcpconnect.println(__eor);

        // current drift adjustment
        tcpconnect.print(Current_drift_adjustment_to_outgoing_NTP_response);
        tcpconnect.print(getdrift());
        tcpconnect.println(EOR);
        
        // data used for drift calculations
        tcpconnect.println(rtc_returned_seconds_elapsed_actual_seconds_elapsed_from_NTP_br);
        for (int i = 0; i < 48; i++) {
          tcpconnect.print(i);
          tcpconnect.print(TEXT_COMMA);
          tcpconnect.print(rtcdriftexpected[i]);
          tcpconnect.print(TEXT_COMMA);
          tcpconnect.print(rtcdriftactual[i]);
          tcpconnect.println(EOR);
        }
      } else if(url==URL_timesync) {
        tcpconnect.println(F("NTP Sync Request received<br>"));
        if(rtcclock().epoch-datetimeAtNTP.epoch>10*60) {
          ntprequest();
          tcpconnect.println(Current_time_is_);
          String retimstr = formattedlocal(rtcclock());
          tcpconnect.print(retimstr);
          retimstr.~String();
          tcpconnect.println(EOL);
        } else {
          tcpconnect.println(NTP_Sync_Request_DENIED_bc_sync_was_just_run_);
          tcpconnect.println(rtcclock().epoch-datetimeAtNTP.epoch);
          tcpconnect.println(seconds_ago_br);
        }
      } else {
        int free = freeMemory();
        tcpconnect.println(br_free_memory_);
        tcpconnect.println(free);
        tcpconnect.println(br_raw_);
        tcpconnect.println(raw);
        tcpconnect.println(br_methodcode_);
        tcpconnect.println(methodcode);
        tcpconnect.println(br_line1_);
        tcpconnect.println(line1);
        tcpconnect.println(br_uri_);
        tcpconnect.println(uri);
        tcpconnect.println(br_url_);
        tcpconnect.println(url);
        tcpconnect.println(br_query_);
        tcpconnect.println(query);
        tcpconnect.println(EOL);
        //char millisinceAP[] = "Millisec since wifi connect=";
        //tcpconnect.println(millisinceAP-millis());
        //tcpconnect.println(uptimeAtAP);
        //tcpconnect.println(EOL);
        tcpconnect.println(This_url_does_not_exist__No_404_error__But_you_need_to_select_one_of_these_adc_live_powermeter_powerhistory_hourly_ntp);
      }
      tcpconnect.println(HTML_CHTML);

      raw.~String();
      line1.~String();
      methodcode.~String();
      uri.~String();
      url.~String();
      query.~String();
    }

    // give the web browser time to receive the data
    //delay(1);

    // close the connection:
    tcpconnect.stop();
    tcpconnect.~WiFiClient();

    if(DEBUG_HTTP_INCOMING) Serial.println(F("client disonnected"));
  }
}

#define REQUESTIN_BUFFER_SIZE 1024 //8192
String serverrequest(WiFiClient tcpconnect) {
  char httprequestin[REQUESTIN_BUFFER_SIZE]; 

  unsigned int index=0;
  boolean currentLineIsBlank = true;
  while (tcpconnect.connected()) {
      if (tcpconnect.available()) {
        char c = tcpconnect.read();
        if(c!=-1) {
          httprequestin[index++] = c;
          if(DEBUG_HTTP_INCOMING) Serial.write(c);
        }
        if (c == '\n' && currentLineIsBlank) {
          // break out of loop and return the request
          break;
        }
        if (c == '\n') {
          // you're starting a new line
          currentLineIsBlank = true;
        } else if (c != '\r') {
          // you've gotten a character on the current line
          currentLineIsBlank = false;
        }
      }
  }
  httprequestin[index] = 0;
  if(DEBUG_HTTP_INCOMING) Serial.println(F("request returned"));

  if(DEBUG_FREE_MEMORY) {
      Serial.print(F("End of HTTP request handler Free memory="));
      Serial.println(freeMemory());    
  }

  return String(httprequestin);
}
String httprequestline(String raw) {
  unsigned int len = raw.length();
  for(int i=0; i<len; i++)
  if(raw[i]=='\n')
    return String(raw).substring(0,i);
  return raw;
}
String httpversion(String requestline) {
  return "Not implemented";
}

#define HTTP_METHOD_UNKNOWN 0
#define HTTP_METHOD_GET     1
#define HTTP_METHOD_HEAD    2
#define HTTP_METHOD_POST    3
#define HTTP_METHOD_PUT     4
#define HTTP_METHOD_DELETE  5
#define HTTP_METHOD_CONNECT 6
#define HTTP_METHOD_OPTIONS 7
#define HTTP_METHOD_TRACE   8
int httpmethod(String requestline) {
    // GET Method. A GET request retrieves data from a web server by specifying parameters in the URL portion of the request. ...
    // HEAD Method. ...
    // POST Method. ...
    // PUT Method. ...
    // DELETE Method. ...
    // CONNECT Method. ...
    // OPTIONS Method. ...
    // TRACE Method.
  if(requestline[0]=='G' && requestline.startsWith("GET "))
    return HTTP_METHOD_GET;
  else if(requestline[0]=='H' && requestline.startsWith("HEAD "))
    return HTTP_METHOD_HEAD;
  else if(requestline[0]=='P') {
    if(requestline[1]=='O' && requestline.startsWith("POST "))
      return HTTP_METHOD_POST;
    if(requestline[1]=='U' && requestline.startsWith("PUT "))
      return HTTP_METHOD_PUT;
  }
  else if(requestline[0]=='D' && requestline.startsWith("DELETE "))
    return HTTP_METHOD_DELETE;
  else if(requestline[0]=='C' && requestline.startsWith("CONNECT "))
    return HTTP_METHOD_CONNECT;
  else if(requestline[0]=='O' && requestline.startsWith("OPTIONS "))
    return HTTP_METHOD_OPTIONS;
  else if(requestline[0]=='T' && requestline.startsWith("TRACE "))
    return HTTP_METHOD_TRACE;
  return HTTP_METHOD_UNKNOWN;
}
String httprequesturi(String requestline) {
  unsigned int len = requestline.length();
  unsigned int start=4;
  unsigned int method=httpmethod(requestline);
  if(method==HTTP_METHOD_GET)
    start=4;
  else if(method==HTTP_METHOD_HEAD)
    start=5;
  else if(method==HTTP_METHOD_POST)
    start=5;
  else if(method==HTTP_METHOD_PUT)
    start=4;
  else if(method==HTTP_METHOD_DELETE)
    start=7;
  else if(method==HTTP_METHOD_CONNECT)
    start=8;
  else if(method==HTTP_METHOD_OPTIONS)
    start=8;
  else if(method==HTTP_METHOD_TRACE)
    start=6;
  else
    for(unsigned int i=0; i<len-1; i++)
      if(requestline[i]==' ') {
        start = i+1;
        break;
      }
      else if(requestline[i]=='\n')
        break;
  //Serial.println(start);
  //Serial.println(len);
  //Serial.println(requestline[start]);
  //Serial.println(requestline.substring(start,len-start));
  
  for(unsigned int i=start; i<len-1; i++)
    if(requestline[i]==' ') {
      //Serial.println(i);
      //Serial.println(requestline.substring(start,i-1));
      //delay(15*1000);
      return requestline.substring(start, i);
    }
  //delay(15*1000);
  return requestline.substring(start, len);
}
String requesturl(String requesturi) {
  unsigned int len = requesturi.length();
  for(unsigned int i=0; i<len; i++)
    if(requesturi[i]=='?')
      return requesturi.substring(i, i);
  return requesturi;
}
String requestquerystring(String requesturi) {
  unsigned int len = requesturi.length();
  for(unsigned int i=0; i<len; i++)
    if(requesturi[i]=='?')
      return requesturi.substring(i, len);
  return "";
}



void configureNetwork() {
  isNetworkConfigured = true;
  
  // char easteregg[] ="/easteregg.bmp";
  // char eastereggsvr[] = "192.168.0.76";
  // httpRequest(eastereggsvr, easteregg, VANPI_WEB_PORT);

  // Check connectivity to Internet thru website
  bool a = httpRequest(ARDUINO_WEB_SERVER, ARDUINO_LOGO_WEBLOCATION, ARDUINO_WEB_PORT, listenToClient);
  disableClear = true;
  bool b = httpsRequest(ADAFRUIT_WEB_SERVER, ADAFRUIT_LOGO_WEBLOCATION, ADAFRUIT_WEB_PORT, listenToSslClient);
  disableClear = false;

  isInternetConnected = a || b;

  if(isInternetConnected)
    timeServer = nistServer;
  else if(httpRequest(VANPI_WEB_SERVER, VANPI_LOGO_WEBLOCATION, VANPI_WEB_PORT, listenToClient)) {
    timeServer = gpsServer;

    // https://forum.arduino.cc/index.php?topic=565994.0
    IPAddress THIS_IP(THIS_IP_1, THIS_IP_2, THIS_IP_3, THIS_IP_4);
    WiFi.config(THIS_IP); //<- static IP
    // wait 10 seconds for connection:
    delay(10000);
    printWifiStatus();
  }

    
  if(!validclock()) 
    ntprequest();  

  if(DEBUG_FREE_MEMORY) {
      Serial.print(F("End of configureNetwork() Free memory="));
      Serial.println(freeMemory());    
  }
}

// this method makes a HTTP connection to the server:
//void httpRequest() {
//  WiFiSSLClient client;
//  unsigned int port = 443;
  // server address:
//  char server[] = "www.arduino.cc";
//  char resource[] = "/asciilogo.txt";
  //bool sendRequest = true; // used to understand if the http request must be sent
bool httpsRequest(char server[], char location[], unsigned int port, httpsResponseReceiver listenHandler) {
  WiFiSSLClient client;

  // Print request time
  if(DEBUG_HTTP_OUTGOING) {
    Serial.println(server);
    Serial.println(location);
    Serial.print(F("Secure Request sent @ "));
    Serial.println(millis());
  }


  if (client.connect(server, port)) {
    // Make a HTTP request:
    client.print("GET ");
    client.print(location);
    client.println(" HTTP/1.1");

    client.print("Host: ");
    client.println(server);
    client.println("Connection: close");
    client.println();


    if(DEBUG_FREE_MEMORY) {
        Serial.print(F("HTTPS request sent, before response, Free memory="));
        Serial.println(freeMemory());    
    }
    if(listenHandler!=0)
      return listenHandler(client); //listenToSslClient(client);
    else
      return true;
  }
  else {
    if(DEBUG_HTTP_OUTGOING) Serial.println(F("connection failed"));
  }
  return false;
}
bool httpRequest(char server[], char location[], unsigned int port, httpResponseReceiver listenHandler) {
  WiFiClient client;

  // Print request time
  if(DEBUG_HTTP_OUTGOING) {
    Serial.println(server);
    Serial.println(location);
    Serial.print(F("Request sent @ "));
    Serial.print(millis());
  }

  if (client.connect(server, port)) {
    // Make a HTTP request:
    client.print("GET ");
    client.print(location);
    client.println(" HTTP/1.1");

    client.print("Host: ");
    client.println(server);
    client.println("Connection: close");
    client.println();

    if(DEBUG_FREE_MEMORY) {
        Serial.print(F("HTTP request sent, before response, Free memory="));
        Serial.println(freeMemory());    
    }
    if(listenHandler!=0)
      return listenHandler(client); // listenToClient(client);
     else
      return true;
  }
  else {
    if(DEBUG_HTTP_OUTGOING) Serial.println(F("connection failed"));
  }
  return false;
}

struct responseParts {
  bool isBmp;
  bool isHtml;
  bool isText;
  int contentType;
  int body;
};
struct responseParts parseResponse(const char* responsebuffer, unsigned int len) {
  uint32_t bodyoffset = 2;
  const char* skip2 = responsebuffer+2;
  char* startat = strstr(skip2 ,"\n\n"); //responsebuffer.indexOf("\n\n",2);

  if(startat) {
    bodyoffset = ((uint32_t)startat - (uint32_t)responsebuffer)+2;
  } else {
    startat = strstr(skip2 ,"\r\n\r\n");  //responsebuffer.indexOf("\r\n\r\n",2);
    if(startat)
        bodyoffset = ((uint32_t)startat - (uint32_t)responsebuffer) +4;
    else if(DEBUG_HTTP_OUTGOING)
      Serial.println(F("Cannot find blank line separating headers from content"));
  }

  char* content = strstr(skip2,"\nContent-Type:"); //responsebuffer.indexOf("\nContent-Type:");
  char* textat = strstr(skip2,"Content-Type: text/plain"); //responsebuffer.indexOf("Content-Type: text/plain");
  char* htmlat = strstr(skip2,"Content-Type: text/html"); //responsebuffer.indexOf("Content-Type: text/html");
  char* bmpat = strstr(skip2,"Content-Type: image/bmp"); //responsebuffer.indexOf("Content-Type: image/bmp");  
  char* bmpat2 = strstr(skip2,"Content-Type: image/x-ms-bmp"); 

  struct responseParts result = {
    bmpat ? (uint32_t)bmpat<(uint32_t)startat : bmpat2 ? (uint32_t)bmpat2<(uint32_t)startat : false, 
    htmlat ? (uint32_t)htmlat<(uint32_t)startat : false, 
    textat ? (uint32_t)textat<(uint32_t)startat : false, 
    content ? (int)((uint32_t)content - (uint32_t)responsebuffer) : -1, 
    bodyoffset
  };
  if(DEBUG_HTTP_OUTGOING) {
    Serial.print("found startat=");
    if(startat)
      Serial.println(trueToStr);
    else
      Serial.println(falseToStr);
    Serial.print("startat offset=");
    Serial.print((uint32_t)startat);
    
    Serial.print(F("found Content-Type: image/bmp="));
    Serial.println(bmpat ? trueToStr : falseToStr);
    Serial.print(F("found Content-Type: x-ms-bmp="));
    Serial.println(bmpat2 ? trueToStr : falseToStr);
    Serial.print("image/bmp offset=");
    Serial.print((uint32_t)bmpat);
    Serial.print("x-ms-bmp offset=");
    Serial.print((uint32_t)bmpat2);
    
    Serial.print(F("Detected bmp="));
    Serial.println(result.isBmp);
  }
  return result;
}

bool listenToSslClient(WiFiSSLClient client)
{ 
  unsigned int index = 0;
  const unsigned int BUFFER_SIZE = 1024*7;
  char responsebuffer[BUFFER_SIZE];
  unsigned long startTime = millis();
  bool received = false;

  if(!isNetworkConfigured) {
    if(DEBUG_HTTP_OUTGOING) Serial.println(null_client_detected_skipping_checking_for_response);
    return false;
  } else if(DEBUG_HTTP_OUTGOING) 
    Serial.println(isNetworkConfigured);

  //String response = "";
  bool flagged = false;
  while ((millis() - startTime < 10000) && !received) { //try to listen for 5 seconds
    if(DEBUG_HTTP_OUTGOING && !flagged) Serial.println(checking_for_https_response);
    while (client.available() && index < BUFFER_SIZE) {
      received = true;
      char c = client.read();
      if(DEBUG_HTTP_OUTGOING) Serial.write(c);
      //response.concat(c);
      responsebuffer[index++] = c;
      if(index>=BUFFER_SIZE) break;
    }
    if(DEBUG_HTTP_OUTGOING) Serial.print(' ');
    if(!flagged) flagged=true;
    if(index>=BUFFER_SIZE) break;
  }
  if(DEBUG_HTTP_OUTGOING) Serial.println(https_response_loop_exit);
  client.stop();
  if(DEBUG_HTTP_OUTGOING) Serial.println(received_);
  if(DEBUG_HTTP_OUTGOING) Serial.println(index);
  responsebuffer[index] = 0; //null terminate


  // Draw some text
  if(received) {
    if(!disableClear) {
      epd.clearBuffer();
      epd.setCursor(10, 100);
      epd.setTextColor(EPD_BLACK);
      String timestr = formattedlocal(rtcclock());
      String space = " ";
      String uptime = String(millis()) + space + timestr + space;
      timestr.~String();
      space.~String();
      epd.print(uptime);
    }
    //String mesg = String(responsebuffer);
    struct responseParts result = parseResponse(&responsebuffer[0], index); //parseResponse(mesg);
    if(result.isHtml || result.isText)    
      drawTextAsBlips(0,0, responsebuffer, result.body, index);
      //epd.print(mesg.substring(0,0,startat, mesg.length()));
    else if(result.isBmp)
      drawBmpOnEPD(125,0, responsebuffer, result.body, index-result.body);
    epd.setCursor(50, 110);
    epd.setTextColor(EPD_INVERSE);
    epd.print(__Web);
    epd.display();

    if(DEBUG_FREE_MEMORY) {
        Serial.print(End_of_HTTPS_request_response_parsing_Free_memory_);
        Serial.println(freeMemory());    
    }
  
    delay(15000);
  }
  return received;
}
bool listenToClient(WiFiClient client)
{
  unsigned int index = 0;
  const unsigned int BUFFER_SIZE = 1024*3;
  char responsebuffer[BUFFER_SIZE];
  unsigned long startTime = millis();
  bool received = false;

  if(!isNetworkConfigured) {
    if(DEBUG_HTTP_OUTGOING) Serial.println(null_client_detected_skipping_checking_for_response);
    return false;
  } else if(DEBUG_HTTP_OUTGOING) 
    Serial.println(isNetworkConfigured);

  //String response = "";
  bool flagged = false;
  while ((millis() - startTime < 10000) && !received) { //try to listen for 5 seconds
    if(DEBUG_HTTP_OUTGOING && !flagged) Serial.println(checking_for_http_response);
    while (client.available() && index < BUFFER_SIZE) {
      received = true;
      char c = client.read();
      if(DEBUG_HTTP_OUTGOING) Serial.write(c);
      //response.concat(c);
      responsebuffer[index++] = c;
      if(index>=BUFFER_SIZE) break;
    }
    if(DEBUG_HTTP_OUTGOING) Serial.print('.');
    if(!flagged) flagged=true;
    if(index>=BUFFER_SIZE) break;
  }
  if(DEBUG_HTTP_OUTGOING) Serial.println(http_response_loop_exit);
  client.stop();
  if(DEBUG_HTTP_OUTGOING) Serial.println(received_);
  if(DEBUG_HTTP_OUTGOING) Serial.println(index);
  responsebuffer[index] = 0; //null terminate


  // Draw some text
  if(received) {
    if(!disableClear) {
      epd.clearBuffer();
      epd.setCursor(10, 100);
      epd.setTextColor(EPD_BLACK);
      String timestr = formattedlocal(rtcclock());
      String space = " ";
      String uptime = String(millis()) + space + timestr + space;
      space.~String();
      timestr.~String();
      epd.print(uptime);
    }
    
    //String mesg = String(responsebuffer);
    struct responseParts result = parseResponse(&responsebuffer[0], index); //parseResponse(mesg);
    if(result.isHtml || result.isText)    
      drawTextAsBlips(0,0, responsebuffer, result.body, index);
      //drawTextAsBlips(0,0,mesg.substring(result.body, mesg.length()));
      //epd.print(mesg.substring(startat, mesg.length()));
    else if(result.isBmp)
      drawBmpOnEPD(125,0,responsebuffer, result.body, index-result.body);
    
    epd.setCursor(50, 110);
    epd.setTextColor(EPD_INVERSE);
    epd.print(__Web);
    epd.display();

    if(DEBUG_FREE_MEMORY) {
        Serial.print(End_of_HTTP_request_response_parsing_Free_memory_);
        Serial.println(freeMemory());    
    }

    delay(15000);
  }
  return received;
}



void print2digits(int number) {
  if (number < 10) {
    Serial.print(F("0"));
  }
  Serial.print(number);
}

// send an NTP request to the time server at the given address
unsigned long sendNTPpacket(IPAddress& address) {

  //Serial.println("1");
  // set all bytes in the buffer to 0
  memset(packetBuffer, 0, NTP_PACKET_SIZE);
  // Initialize values needed to form NTP request
  // (see URL above for details on the packets)
  //Serial.println("2");
  packetBuffer[0] = 0b11100011;   // LI, Version, Mode
  packetBuffer[1] = 0;     // Stratum, or type of clock
  packetBuffer[2] = 6;     // Polling Interval
  packetBuffer[3] = 0xEC;  // Peer Clock Precision
  // 8 bytes of zero for Root Delay & Root Dispersion
  packetBuffer[12]  = 49;
  packetBuffer[13]  = 0x4E;
  packetBuffer[14]  = 49;
  packetBuffer[15]  = 52;

  //Serial.println("3");

  // all NTP fields have been given values, now
  // you can send a packet requesting a timestamp:
  Udp2390.beginPacket(address, 123); //NTP requests are to port 123
  //Serial.println("4");
  Udp2390.write(packetBuffer, NTP_PACKET_SIZE);
  //Serial.println("5");
  if(DEBUG_NTP) Serial.println(F("NTP UDP sent"));
  Udp2390.endPacket();
  //Serial.println("6");  
}


bool validclock(){
  if(datetimeAtNTP.epoch==0 && datetimeAtNTP.year==0 && datetimeAtNTP.month==0 && datetimeAtNTP.day==0 && datetimeAtNTP.hour==0 && datetimeAtNTP.minute==0 && datetimeAtNTP.second==0)
    return false; //never initiallized by NTP, despite RTC started

  return true;
}

unsigned long rtcexpiration = 60;
bool isclockstale(){
  if(!validclock())
    return true; //never initiallized by NTP, despite RTC started

  uint32_t estimated = rtc.getEpoch();
  uint32_t lastrefresh = datetimeAtNTP.epoch;
  unsigned long age = estimated - lastrefresh;
  if(DEBUG_NTP) {
    Serial.print(F("Clock age = "));
    Serial.println(age);
  }
  if(age > rtcexpiration) { 
    return true;
  }

  //https://www.google.com/url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
  //millis() and micros() overflow after around 50 days and 70 minutes, respectively.
  if(millis() < uptimeAtNTP) // let's make it easy to calculate time in milliseconds between events
    return true;

   return false;
}

void ntprequest() {  
  // log drift of RTC, differing from NTP
  unsigned long rtcepoch = rtcclock().epoch;
  unsigned long expecteddelta = rtcepoch - datetimeAtNTP.epoch;

  if(DEBUG_NTP) Serial.println(Sending_NTP_packet);
  unsigned long start = millis();
  Udp2390.flush();
  sendNTPpacket(timeServer); // send an NTP packet to a time server
  // wait to see if a reply is available
  delay(1000);
  if (Udp2390.parsePacket()) {
    unsigned long end = millis();
    if(DEBUG_NTP) Serial.println(packet_received);
    
    // We've received a packet, read the data from it
    Udp2390.read(packetBuffer, NTP_PACKET_SIZE); // read the packet into the buffer
    Udp2390.flush();

    //the timestamp starts at byte 40 of the received packet and is four bytes,
    // or two words, long. First, esxtract the two words:

    unsigned long highWord = word(packetBuffer[40], packetBuffer[41]);
    unsigned long lowWord = word(packetBuffer[42], packetBuffer[43]);
    // combine the four bytes (two words) into a long integer
    // this is NTP time (seconds since Jan 1 1900):
    unsigned long secsSince1900 = highWord << 16 | lowWord;
    if(DEBUG_NTP) {
      Serial.print(Seconds_since_Jan_1_1900_);
      Serial.println(secsSince1900);
    }

    // now convert NTP time into everyday time:
    // Unix time starts on Jan 1 1970. In seconds, that's 2208988800:
    const unsigned long seventyYears = 2208988800UL;
    // subtract seventy years:
    unsigned long epoch = secsSince1900 - seventyYears;
    rtc.setEpoch(epoch); //set internal clock as soon as possible to reduce lag-behind
    uptimeAtNTP = millis();  //only for reference, in case someone wants to know time by millseconds
    
    // print Unix time:
    if(DEBUG_NTP) {
      Serial.print(Unix_time_);
      Serial.println(epoch);
    }

    // submit data for checking for rtc clock drift
    //int drifthour = (byte)(expecteddelta/3600);
    // excludeEpochFromDrift is epoch of rtc updated w/o NTP.  so delta from that time would throw off the drift regression.
    if(datetimeAtNTP.epoch!=0 && datetimeAtNTP.epoch!=excludeEpochFromDrift) {
      long actualdelta = epoch - datetimeAtNTP.epoch;
      //int index = drifthour+1; //rechecking time one hour later, is stored in 0
      rtcdriftexpected[rtcdriftindex] = expecteddelta;
      rtcdriftactual[rtcdriftindex] = actualdelta;
      if(DEBUG_NTP) {
        Serial.print(Epoch_or_date_in_seconds_when_last_synced_with_NTP_);
        Serial.println(datetimeAtNTP.epoch);      
        Serial.print(Epoch_or_date_in_seconds_of_RTC_);
        Serial.println(rtcepoch);
        Serial.print(Seconds_passed_on_RTC_therefore_Expected_from_NTP_);
        Serial.println(expecteddelta);
        Serial.print(Epoch_or_date_in_seconds_of_NTP_response_);
        Serial.println(datetimeAtNTP.epoch);
        Serial.print(Seconds_passed_according_to_NTP_therefore_actual_);
        Serial.println(actualdelta);
        Serial.print(Data_bin_for_drift_calculation_);
        Serial.println(rtcdriftindex);
      }

      int mn, md, b, r;
      int code = linreg(48, rtcdriftexpected, rtcdriftactual, &mn, &md, &b, &r);
      if(code==0) {
        if(DEBUG_NTP) Serial.print(rtc_clock_drift_calculated);
        rtcdrift.Bn = mn;
        rtcdrift.Bd = md; //1; 
        rtcdrift.A = b;
      }

      rtcdriftindex++;
      if(rtcdriftindex>47)rtcdriftindex=0;
    }

    // print the hour, minute and second:
    unsigned long hr = rtc.getHours();
    unsigned long mi = rtc.getMinutes();
    unsigned long se = rtc.getSeconds();
    if(DEBUG_NTP) {
      Serial.print(The_UTC_time_is);       // UTC is the time at Greenwich Meridian (GMT)
      Serial.print(hr); // print the hour (86400 equals secs per day)
      Serial.print(':');
      if (mi < 10) {
        // In the first 10 minutes of each hour, we'll want a leading '0'
        Serial.print('0');
      }
      Serial.print(mi); // print the minute (3600 equals secs per minute)
      Serial.print(':');
    
      if (se < 10) {
        // In the first 10 seconds of each minute, we'll want a leading '0'
        Serial.print('0');
      }
      Serial.println(se); // print the second
    }
    

    //https://stackoverflow.com/questions/7960318/math-to-convert-seconds-since-1970-into-date-and-vice-versa
    //tm_sec 
    //+ tm_min*60 
    //+ tm_hour*3600 
    //+ tm_yday*86400 
    //+ (tm_year-70)*31536000 
    //+ ((tm_year-69)/4)*86400 
    //- ((tm_year-1)/100)*86400 
    //+ ((tm_year+299)/400)*86400
    struct utcdatetime utc = rtcclock();
    if(DEBUG_NTP) { 
      Serial.print(rtcclock_returned_year_month_day_hr_min_sec_);
      Serial.println(utc.year);
      Serial.println(utc.month);
      Serial.println(utc.day);
      Serial.println(utc.hour);
      Serial.println(utc.minute);
      Serial.println(utc.second);
    }
    
    // Everytime we successfully get a datetime with NTP, record the synctime with real UTC time
    //uptimeAtNTP = end > start ? (start+end)/2 : end;
    //memset( &aStruct, 0, sizeof(aStruct) );
    //memcpy(dst, src, sizeof(src[0])*len);
    memcpy(&datetimeAtNTP, &utc, sizeof(utcdatetime));

    //set the boot time
    if(datetimeAtConnect.epoch==0) {
      datetimeAtConnect = datetimeAtNTP;
    }

    // Compute time of next NTP refresh
    // https://www.wikihow.com/Change-the-Time-Synchronization-Interval-in-Windows
    // It specifies no more than 1/15min... the code below breaks that rule, but just for 18min.  Then it's on average, once a day.
    if(rtcexpiration<60*48) // re-sync 1 min, 2 min, 3 min, until is refreshed
      rtcexpiration+=60;
    else // re-sync 1 hr, 2 hr, 3 hr, until is refreshed
      rtcexpiration+=3600;
    //rtcexpiration += 3600;
    if(rtcexpiration>2592000)
      rtcexpiration = 3600;

    // Draw some text
    epd.clearBuffer();
    epd.setCursor(0, 10);
    epd.setTextSize(2);
    epd.setTextColor(EPD_BLACK);
    String uptime = String(millis());
    //epd.print(uptime + "\n" + String(hr) + ":" + String(mi) + ":" + String(se));
    String timestr = formattedlocal(utc);
    timestr.replace(" ","\n");
    String output = "Uptime:"+uptime + "ms\n" + timestr;
    timestr.~String();
    if(DEBUG_NTP) Serial.println(output); 
    epd.print(output);
    epd.setCursor(150, 70);
    epd.setTextSize(1);
    epd.setTextColor(EPD_RED);
    epd.print(__NTP);
    //epd.display();

    if(DEBUG_FREE_MEMORY) {
        Serial.print(End_of_NTPRequest_Free_memory_);
        Serial.println(freeMemory());    
    }

    //delay(15000);
    
    epdDisplayDeferredDelay(); // this needs to be here, bc this can be executed anytime the clock goes stale, even within 15sec of a refrsh

    //checks if the UDP buffer has more data, and throw away
    int limit = Udp2390.parsePacket();
    while(Udp2390.parsePacket() && (limit--)>0) {
      // the get the last packet of data, so that old data doesn't affect this
      Udp2390.read(packetBuffer, NTP_PACKET_SIZE); // read the packet into the buffer
      Udp2390.flush();
      delay(500);
    }
  }
  else {
    if(DEBUG_NTP)
      Serial.println(No_NTP_response_received);
      
    //if we can't update NTP, perhaps we can adjust the clock a little
    /*if(rtcdrift.Bn!=0 || rtcdrift.A!=0){
      unsigned long estimateddelta = rtcdrift.A + expecteddelta * rtcdrift.Bn / rtcdrift.Bd;
      if(estimateddelta!=expecteddelta) {
        rtc.setEpoch(datetimeAtNTP.epoch + estimateddelta);
        if(DEBUG_NTP)
          Serial.println("RTC adjusted for drift to NTP server: " + String(estimateddelta-expecteddelta) + "sec");
      }
    }*/
    
    /* 12/25, Don't adjust the RTC according to what you think the drift should be.
     *  THe below logic has a problem.  And the existing RTC drift is better than figuring out what is wrong w the algorithm below.
    unsigned long estimateddelta = computedrift(expecteddelta);
    if(estimateddelta!=expecteddelta) {
      unsigned long driftadjustedepoch = datetimeAtNTP.epoch + estimateddelta;
      rtc.setEpoch(driftadjustedepoch);
      excludeEpochFromDrift = driftadjustedepoch;

      if(DEBUG_NTP) {
        Serial.print(RTC_adjusted_for_drift_to_NTP_server_);
        Serial.print((long)estimateddelta-(long)expecteddelta);
        Serial.println(sec);
      }
    }*/
  }
}
long getdrift() {
  if(rtcdrift.Bn!=0 || rtcdrift.A!=0) {
    unsigned long rtcepoch = rtcclock().epoch;
    unsigned long expecteddelta = rtcepoch - datetimeAtNTP.epoch;
    unsigned long est = computedrift(expecteddelta);
    if(expecteddelta!=est)
      return est-expecteddelta;
  }
  return 0;
}
unsigned long computedrift(unsigned long expecteddelta) {
  if((rtcdrift.Bn!=0 || rtcdrift.A!=0) && rtcdrift.Bd!=0){
    unsigned long estimateddelta = rtcdrift.A + expecteddelta * rtcdrift.Bn / rtcdrift.Bd;
    unsigned long overflowmax = 2147483647 / rtcdrift.Bn; // this max starts at 3072 and gets smaller as the m numbers get bigger(more precise fractions)
    if(expecteddelta>overflowmax) { 
      double x = double(expecteddelta);
      double m = double(rtcdrift.Bn)/double(rtcdrift.Bd);
      double mx = x * m;
      estimateddelta = rtcdrift.A + (unsigned long)mx;
    }
    if(estimateddelta!=expecteddelta) {
      return estimateddelta;
    }
  }
  return expecteddelta;  
}

struct utcdatetime rtcclock() {
  uint32_t epoch = rtc.getEpoch();
  uint8_t se = rtc.getSeconds();
  uint8_t mi = rtc.getMinutes();
  uint8_t hr = rtc.getHours();
  uint8_t da = rtc.getDay();
  uint8_t mo = rtc.getMonth();
  uint16_t yr = rtc.getYear();
  if(yr<100) yr +=2000;

  //struct utcdatetime {
  //  unsigned long epoch;
  //  unsigned int year;
  //  unsigned int month;
  //  unsigned int day;
  //  unsigned int hour;
  //  unsigned int minute;
  //  unsigned int second;
  //};

  struct utcdatetime utc = { epoch, yr, mo, da, hr, mi, se };
  
  return utc;
}

/*
unsigned long ntpage() {
  if(validclock())
    return millis() - uptimeAtNTP;
  else
    return 0;
}*/
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
