studio-1b/Solar-Power-Meter/ArduinoCode/arduino_secrets.h

#define SECRET_SSID "SSID"
#define SECRET_PASS "SharedPassword"

//octets of this IP
#define THIS_IP_1  192
#define THIS_IP_2  168
#define THIS_IP_3  1
#define THIS_IP_4  2

//octets of IP, for GPSD server, if internet is not reacheable
#define GPSD_IP_1  192
#define GPSD_IP_2  168
#define GPSD_IP_3  1
#define GPSD_IP_4  255
#define GPSD_IP_STR  "192.168.1.255"
