studio-1b/Solar-Power-Meter/(commit log)

2020-05-07 collected all project files for wifi accessible solar power meter, and aggregated here in git
2020-05-21 1. fixed bugs in calibration code 2. added cleanup code to poll and job to cron
